kruglovvs/usbip_debugger/docs/code-specification.docx

| | УТВЕРЖДАЮ
| | _________________________
| | _________________________
| | “_____”____________20__

ВСТРОЕННОЕ ПРОГРАММНОЕ ОБЕСПЕЧЕНИЕ

Спецификация

Лист утверждения

А.В.00001-01 01

ИУ4.11.03.03.21.83.13.030 01-лу

Инв. № подл.

Подпись и дата

Взам. инв. №

Инв. № дубл.

Подпись и дата

| | Руководитель разработки
| | ______________________
| | ______________________
| | “_____”____________20__
| | Ответственный исполнитель
| | ______________________
| | ______________________
| | “_____”____________20__

УТВЕРЖДЕНО

ИУ4.11.03.03.21.83.13.030 01-лу

ВСТРОЕННОЕ ПРОГРАММНОЕ ОБЕСПЕЧЕНИЕ

Спецификация

Инв. № подл.

Подпись и дата

Взам. инв. №

Инв. № дубл.

Подпись и дата

ИУ4.11.03.03.21.83.13.030 01

Обозначение | Наименование | Примечание
| Документация
ИУ4.11.03.03.21.83.13.030 01-ЛУ | Встроенное программное
| обеспечение
| Спецификация
| Лист утверждения
ИУ4.11.03.03.21.83.13.030 12 | Встроенное программное
| обеспечение
| Текст программы
ИУ4.11.03.03.21.83.13.030 51 | Встроенное программное
| обеспечение
| Программа и методика испытаний
ИУ4.11.03.03.21.83.13.030 51-ЛУ | Встроенное программное
| обеспечение
| Программа и методика испытаний
| Лист утверждения

#### Лист регистрации изменений

Номера листов (страниц) | | | | | Всего листов (страниц) в докум | № документа | Входящий № сопрово дительного документа и дата | Подп. | Дата
Изм | изменен ных | заме ненных | новых | анулиро ванных
