kruglovvs/usbip_debugger/docs/device_speccification.pdf

Копировал | Формат A4 Инв. № подл. Подп. и дата Взам. инв. № Инв. № дубл. Подп. и дата Справ. № Перв. примен.
Изм. Лист | | № докум. | Подп. | Дата
| | Разраб. | Круглов В. С. | | JTAG/SWD программатор для удалённой отладки через Wi-Fi | Лит. | Лист | Листов
Пров. | Леонидов В. В. | | | | | | | 1

Н. контр.

Утв. Форм. | Зона | Поз. | Обозначение | Наименование | Кол. | Примечание
| | Документация
А2 | ИУ4.11.03.03.21.83.13.003 СБ | Сборочный чертёж
А4 | ИУ4.11.03.03.21.83.13.001 | Электронная ячейка
А2 | ИУ4.11.03.03.21.83.13.004 | Основание корпуса
А2 | ИУ4.11.03.03.21.83.13.005 | Крышка корпуса
| | Сборочные единицы
1 | ИУ4.11.03.03.21.83.13.001 | Электронная ячейка | 1
| | Детали
2 | ИУ4.11.03.03.21.83.13.004 | Основание корпуса | 1
3 | ИУ4.11.03.03.21.83.13.005 | Крышка корпуса | 1
| Стандартные изделия
4 | Саморез с потайной головкой M2x6-4,8-H | 4
| ГОСТ Р ИСО 7046-1-2013

МГТУ им. Н. Э. Баумана
Кафедра ИУ4
Группа ИУ4-83Б

ИУ4.11.03.03.21.83.13.003
