kruglovvs/usbip_debugger/docs/pcb_specification.pdf

Копировал | Формат A4 Инв. № подл. Подп. и дата Взам. инв. № Инв. № дубл. Подп. и дата Справ. № Перв. примен.
Изм. Лист | | № докум. | Подп. | Дата
| | Разраб. | Круглов В. С. | | Плата печатная многослойная | Лит. | Лист | Листов
Пров. | Леонидов В. В. | | | | | | | 1

Н. контр.

Утв. Форм. | Зона | Поз. | Обозначение | Наименование | Кол. | Примечание
| | Документация
А2 | ИУ4.11.03.03.21.83.13.002 СБ | Сборочный чертёж
| ИУ4.11.03.03.21.83.13.002 М | Плата печатная данные элементов структуры
А4 | ИУ4.11.03.03.21.83.13.002 М-ЛУ | Плата печатная данные элементов структуры
| | лист утверждения
| Материалы
1 | Стеклотекстолит FR4 ТУ И03.0107.008-94 | 1313 | мм²
2 | Препрег ТУ 5952-007-20552865-2015 | 2625 | мм²
3 | Фольга медная толщина 18мкм | 5250 | мм²
| ТУ 1844-004-99267323-2008

МГТУ им. Н. Э. Баумана
Кафедра ИУ4
Группа ИУ4-83Б

ИУ4.11.03.03.21.83.13.002
