kruglovvs/usbip_debugger/docs/pcba_specification.pdf

Копировал | Формат A4 Инв. № подл. Подп. и дата Взам. инв. № Инв. № дубл. Подп. и дата Справ. № Перв. примен.
Изм. Лист | | № докум. | Подп. | Дата
| | Разраб. | Круглов В. С. | | Электронная ячейка JTAG/SWD программатора для удалённой отладки через Wi-Fi | Лит. | Лист | Листов
Пров. | Леонидов В. В. | | | | | | 1 | 2

Н. контр.

Утв. Форм. | Зона | Поз. | Обозначение | Наименование | Кол. | Примечание
| | Документация
А2 | ИУ4.11.03.03.21.83.13.001 СБ | Сборочный чертёж
А2 | ИУ4.11.03.03.21.83.13.001 Э1 | Схема электрическая структурная
А3 | ИУ4.11.03.03.21.83.13.001 Э2 | Схема электрическая функциональная
А2 | ИУ4.11.03.03.21.83.13.001 Э3 | Схема электрическая принципиальная
А2 | ИУ4.11.03.03.21.83.13.001 Э4 | Схема электрическая соединений
| ИУ4.11.03.03.21.83.13.001 М | Встроенное программное обеспечение
А4 | ИУ4.11.03.03.21.83.13.001 М-ЛУ | Встроенное программное обеспечение
| | лист утверждения
А4 | ИУ4.11.03.03.21.83.13.001 ПЭ3 | Перечень элементов
А2 | ИУ4.11.03.03.21.83.13.002 | Плата печатная многослойная
| | Сборочные единицы
1 | ИУ4.11.03.03.21.83.13.002 | Плата печатная многослойная | 1
| Прочие изделия
| Разъёмы
2 | USB4110-GF-A (GCT, США) | 1 | XS1
3 | 2213SM-10G-TB (Multicomp, Австралия) | 1 | XP1
| Конденсаторы
4 | GRM188R61C106KAALD (Murata, Япония) | 6 | C1..C6
5 | GRM1885C1H6R3WA01D (Murata, Япония) 1 | | C7
| Резисторы
6 | Р1-12-0,125-43Ом±5%-М-"А" | 3 | R4, R6, R9
7 | Р1-12-0,125-68Ом±5%-М-"А" | 5 | R14..R18
8 | Р1-12-0,125-5,1кОм±5%-М-"А" | 4 | R1..R3, R8
9 | Р1-12-0,125-24кОм±5%-М-"А" | 2 | R5, R7
| | ИУ4.11.03.03.21.83.13.001

МГТУ им. Н. Э. Баумана
Кафедра ИУ4
Группа ИУ4-83Б

Копировал | Формат A4 Инв. № подл. Подп. и дата Взам. инв. № Инв. № дубл. Подп. и дата Справ. № Перв. примен.
Изм. Лист | № докум. | Подп. | Дата

Лист

2 Форм. | Зона | Поз. | Обозначение | Наименование | Кол. | Примечание
| | 10 | | Р1-12-0,125-100кОм±10%-М-"А" | 4 | R10..R13
| Светодиоды
11 | FYLS-0603UGC (Foryard, Китай) | 1 | VD1
12 | FYLS-0603UBC (Foryard, Китай) | 1 | VD2
13 | FYLS-0603URC (Foryard, Китай) | 1 | VD3
| Микросхемы
14 | SRV05-4.TCT (Semtech, США) | 1 | DA1
15 | TLV62569DBVR (Texas Instruments, США) | 1 | DA2
16 | TXB0106PWR (Texas Instruments, США) | 1 | DD2
17 | ESP32-S3-WROOM-1-N16R8 (Espressif, Китай) 1 | | DD1
18 | IHLP2020CZER2R2M01 (Vishay Intertechnology, США) | 1 | L1

ИУ4.11.03.03.21.83.13.001
