kruglovvs/usbip_debugger/docs/bomdoc.pdf

Копировал | Формат A4 Инв. № подл. Подп. и дата Взам. инв. № Инв. № дубл. Подп. и дата Справ. № Перв. примен.
Изм. Лист | № докум. | Подп. | Дата
| Разраб. | Круглов В. С. | | Электронная ячейка JTAG/SWD программатора для удалённой отладки через Wi-Fi Перечень элементов | Лит. | Лист | Листов
Пров. | | | | | | | 1

Н. контр.
Утв.
Поз. обозначение | Наименование | Кол. | Примечание
| Разъёмы
XS1 | USB4110-GF-A (GCT, США) | 1
XP1 | 2213SM-10G-TB (Multicomp, Австралия) | 1
| Конденсаторы
C1..C6 | GRM188R61C106KAALD (Murata, Япония) | 6
C7 | GRM1885C1H6R3WA01D (Murata, Япония) | 1
| Резисторы
R4, R6, R9 Р1-12-0,125-43Ом±5%-М-"А" | | 3
R14..R18 | Р1-12-0,125-68Ом±5%-М-"А" | 5
R1..R3, R8 | Р1-12-0,125-5,1кОм±5%-М-"А" | 4
R5, R7 | Р1-12-0,125-24кОм±5%-М-"А" | 2
R10..R13 | Р1-12-0,125-100кОм±10%-М-"А" | 4
| Светодиоды
VD1 | FYLS-0603UGC (Foryard, Китай) | 1
VD2 | FYLS-0603UBC (Foryard, Китай) | 1
VD3 | FYLS-0603URC (Foryard, Китай) | 1
| Микросхемы
DA1 | SRV05-4.TCT (Semtech, США) | 1
DA2 | TLV62569DBVR (Texas Instruments, США) | 1
DD2 | TXB0106PWR (Texas Instruments, США) | 1
DD1 | ESP32-S3-WROOM-1-N16R8 (Espressif, Китай) | 1
L1 | IHLP2020CZER2R2M01 (Vishay, США) | 1

# ИУ4.11.03.03.21.83.13.001 ПЭ3

МГТУ им. Н. Э. Баумана
Кафедра ИУ4
Группа ИУ4-83Б

# Леонидов В. В. ИУ4.11.03.03.2¹.83.13.00¹
