kruglovvs/usbip_debugger/docs/gerber_lu.pdf

Копировал | Формат A4 Инв. № подл. Подп. и дата Взам. инв. № Инв. № дубл. Подп. и дата Справ. № Перв. примен.
Изм. Лист | | № докум. | Подп. | Дата
| | Разраб. | Круглов В. С. | | Плата печатная многослойная данные элементов структуры Информационно-удостоверяющий лист | Лит. | Лист | Листов
Пров. | Леонидов В. В. | | | | | | | 1

Н. контр.
Утв.
| | Номер п/п | Обозначение | Наименование документа | Версия | Дата последнего изменения
| | 1 ИУ4.11.03.03.21.83.13.002 М | | Плата печатная многослойная данные элементов структуры
MD5 | b7d25142cd10724d77d720eb7b6e8429
Имя файла | Примечание

gerbers.zip

# ИУ4.11.03.03.21.83.13.002 М-УЛ

МГТУ им. Н. Э. Баумана
Кафедра ИУ4
Группа ИУ4-83Б
