kruglovvs/usbip_debugger/docs/thermal.pdf

## Моделирование теплового режима

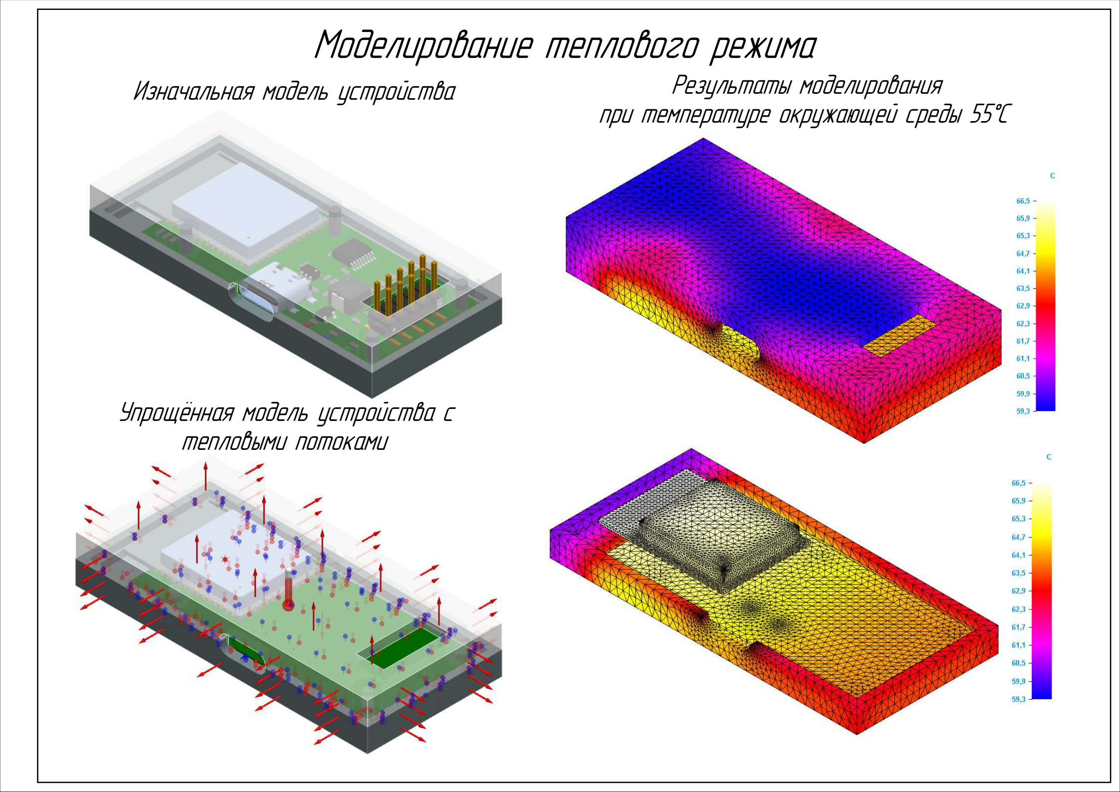
[picture p82: page 1]

Изначальная модель устройства | Результаты моделирования при температуре окружающей среды 55°C

Упрощённая модель устройства с тепловыми потоками
