kruglovvs/usbip_debugger/hardware/case/pattern.stp

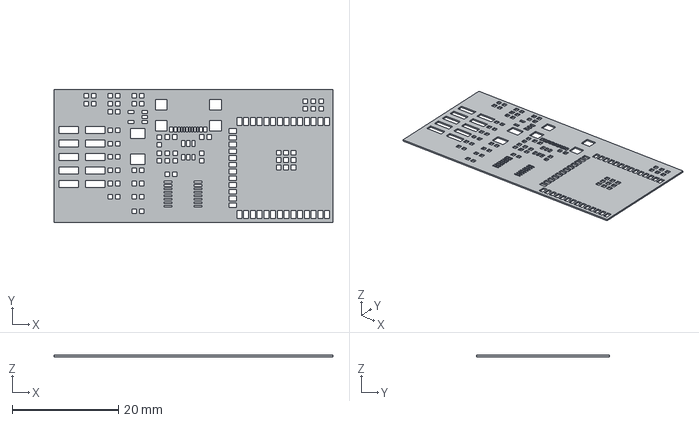
[picture p83: CAD file, 2025-06-28]
hardware/case/pattern.stp
52.5 x 25.0 x 0.3 mm
