kruglovvs/usbip_debugger/hardware/case/pcb-3d/pcb.step

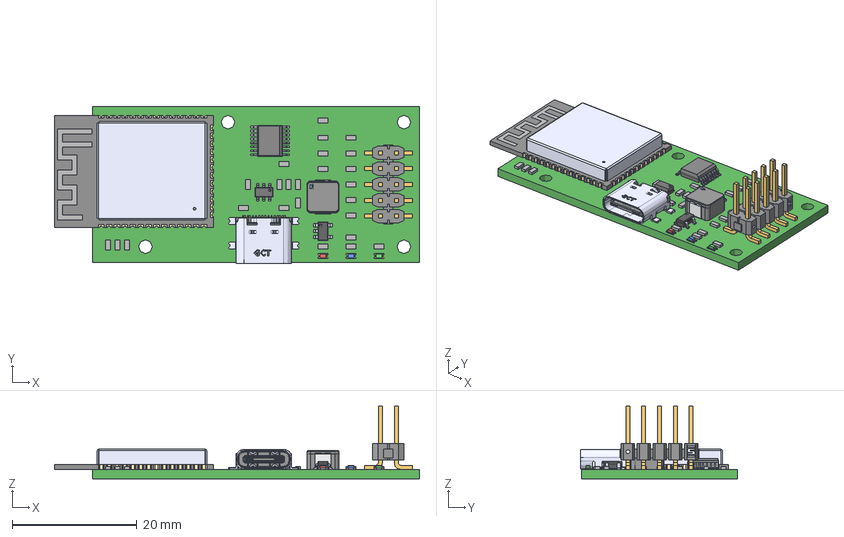
[picture p84: CAD file, 2025-06-28]
hardware/case/pcb-3d/pcb.step
58.6 x 25.2 x 11.7 mm
SW3dPS-0603_SMD_Capacitor x 7
Extruded x 25
chip_0603_r x 18
SOT23-5-1
ssop16
GCT
IHLP2020AB
Vishay_logo_-_Copy
Vishay_logo
T-1S6-16(-01-5-DV)
TSM-105-01-DV_body
logo
User_Library-LED_0603_R_Pocket002
User_Library-LED_0603_R_Pad004
User_Library-LED_0603_R_Fillet
User_Library-LED_0603_R_Pocket001
User_Library-LED_0603_R_Pad
User_Library-LED_0603_B_Pocket002
User_Library-LED_0603_B_Pad004
User_Library-LED_0603_B_Fillet
User_Library-LED_0603_B_Pocket001
User_Library-LED_0603_B_Pad
User_Library-LED_0603_G_Pocket002
User_Library-LED_0603_G_Pad004
User_Library-LED_0603_G_Fillet
User_Library-LED_0603_G_Pocket001
User_Library-LED_0603_G_Pad
User_Library-SOT23-6-2
