kruglovvs/usbip_debugger/hardware/model/FEM/heat.FCStd

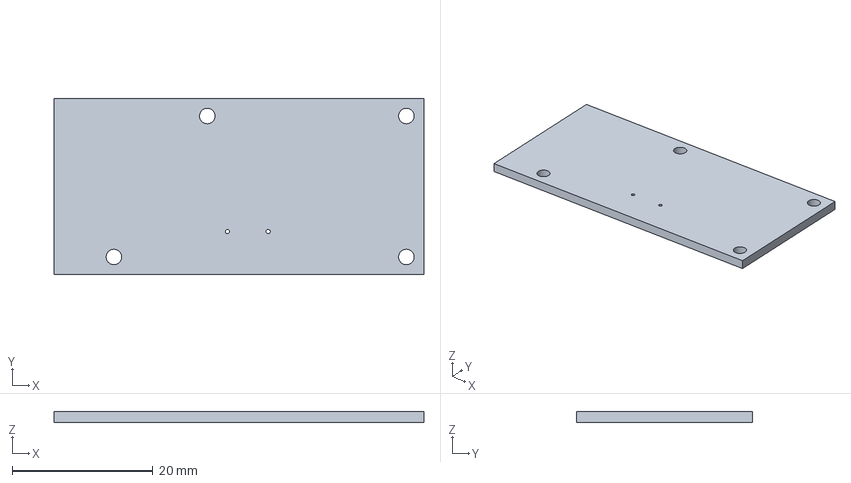
[picture p85: CAD file, 2025-06-28]
hardware/model/FEM/heat.FCStd
52.5 x 25.0 x 1.52 mm
