kruglovvs/usbip_debugger/docs/3D_assembly.pdf

## Последовательность сборки

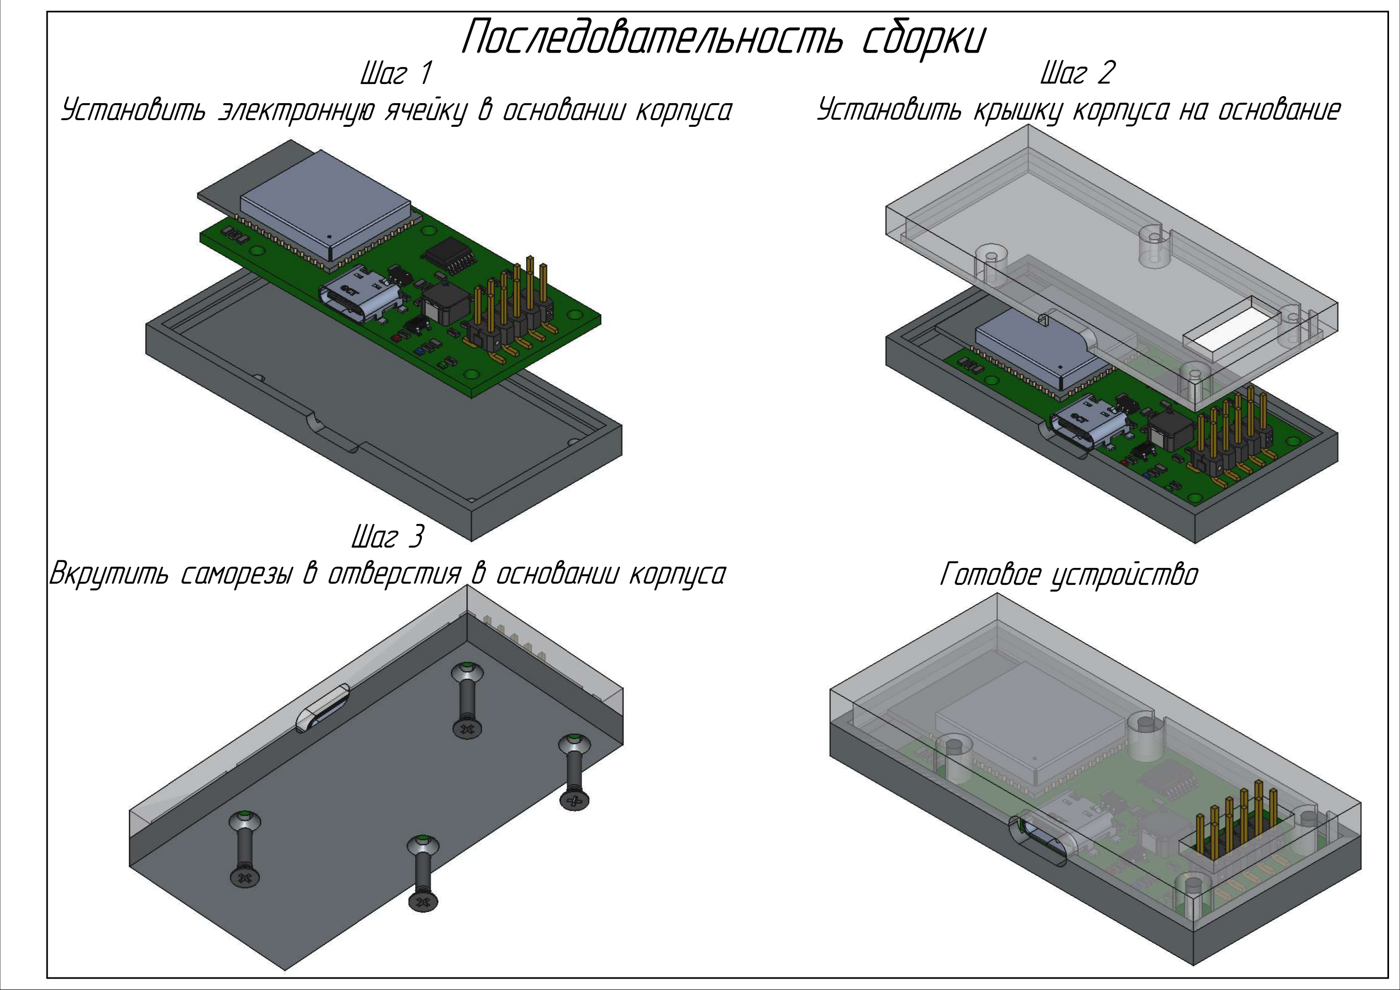
[picture p86: page 1]

Шаг 1
Установить электронную ячейку в основании корпуса

Шаг 2
Установить крышку корпуса на основание

Шаг 3
Вкрутить саморезы в отверстия в основании корпуса | Готовое устройство
