kruglovvs/usbip_debugger/docs/assembly.pdf

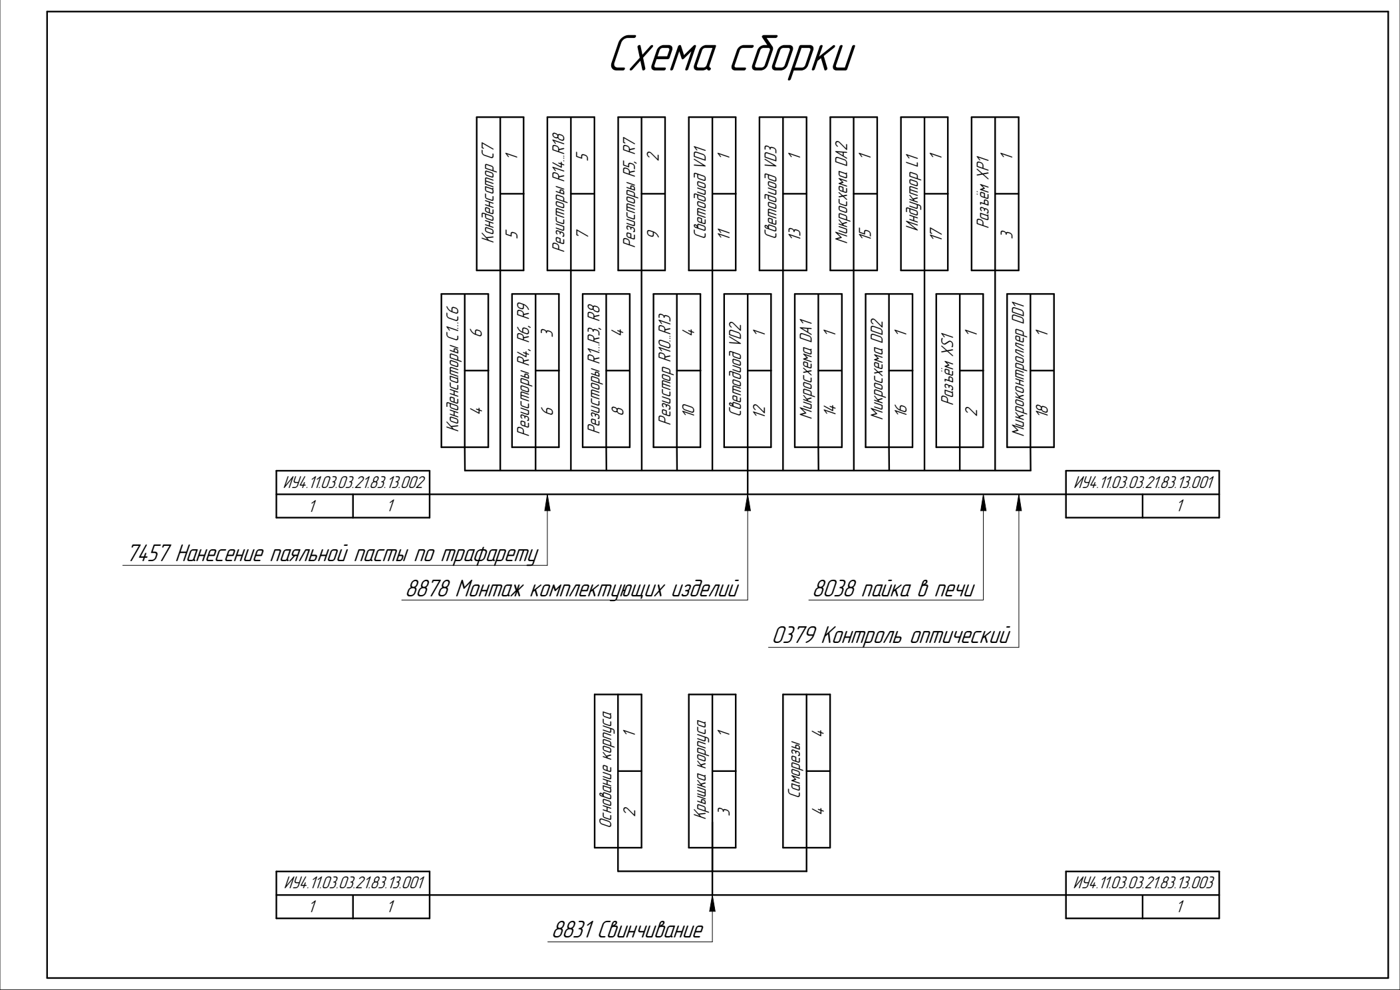
[picture p87: figure]
0379 Контроль оптический; 8831 Свинчивание; 1 Основание корпуса; 1 Крышка корпуса 3 1 Саморезы; Конденсаторы C¹...C6; 6 Резисторы R4, R6, R9 6 3 Резисторы R1...R3, R8 8; 1 Резисторы R14...R18 7; 5 Светодиод VD2 12; 1 Микросхема DA1 14; 1 Микросхема DD2 16 1 Разъём XS1; 1 Резисторы R5, R7 9 2 Светодиод VD1 11; 1 Светодиод VD3 13; 1 Микросхема DA2 15 1 Индуктор L1 17; 1 Разъём XP1; 1 Микроконтроллер DD1 18; Схема сборки

# 8878 Монтаж комплектующих изделий 8038 пайка в печи

# 7457 Нанесение паяльной пасты по трафарету

ИУ4.11.03.03.21.83.13.002 | ИУ4.11.03.03.21.83.13.001

### 4 Резистор R10...R13 10 4 Конденсатор C7 5
