kruglovvs/usbip_debugger/docs/testing.pdf

## Испытание устройства

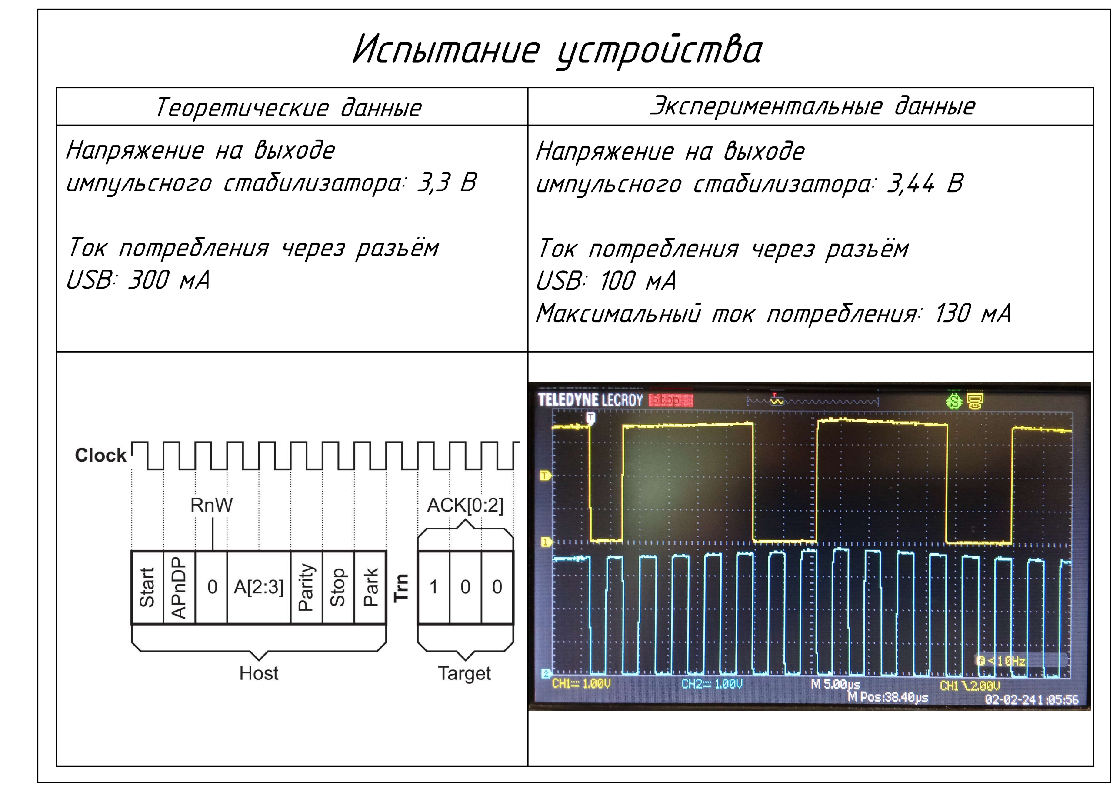
[picture p88: page 1]

Теоретические данные | Экспериментальные данные
Напряжение на выходе импульсного стабилизатора: 3,3 В Ток потребления через разъём USB: 300 мА | Напряжение на выходе импульсного стабилизатора: 3,44 В Ток потребления через разъём USB: 100 мА Максимальный ток потребления: 130 мА
