kruglovvs/usbip_debugger/docs/schematic.pdf

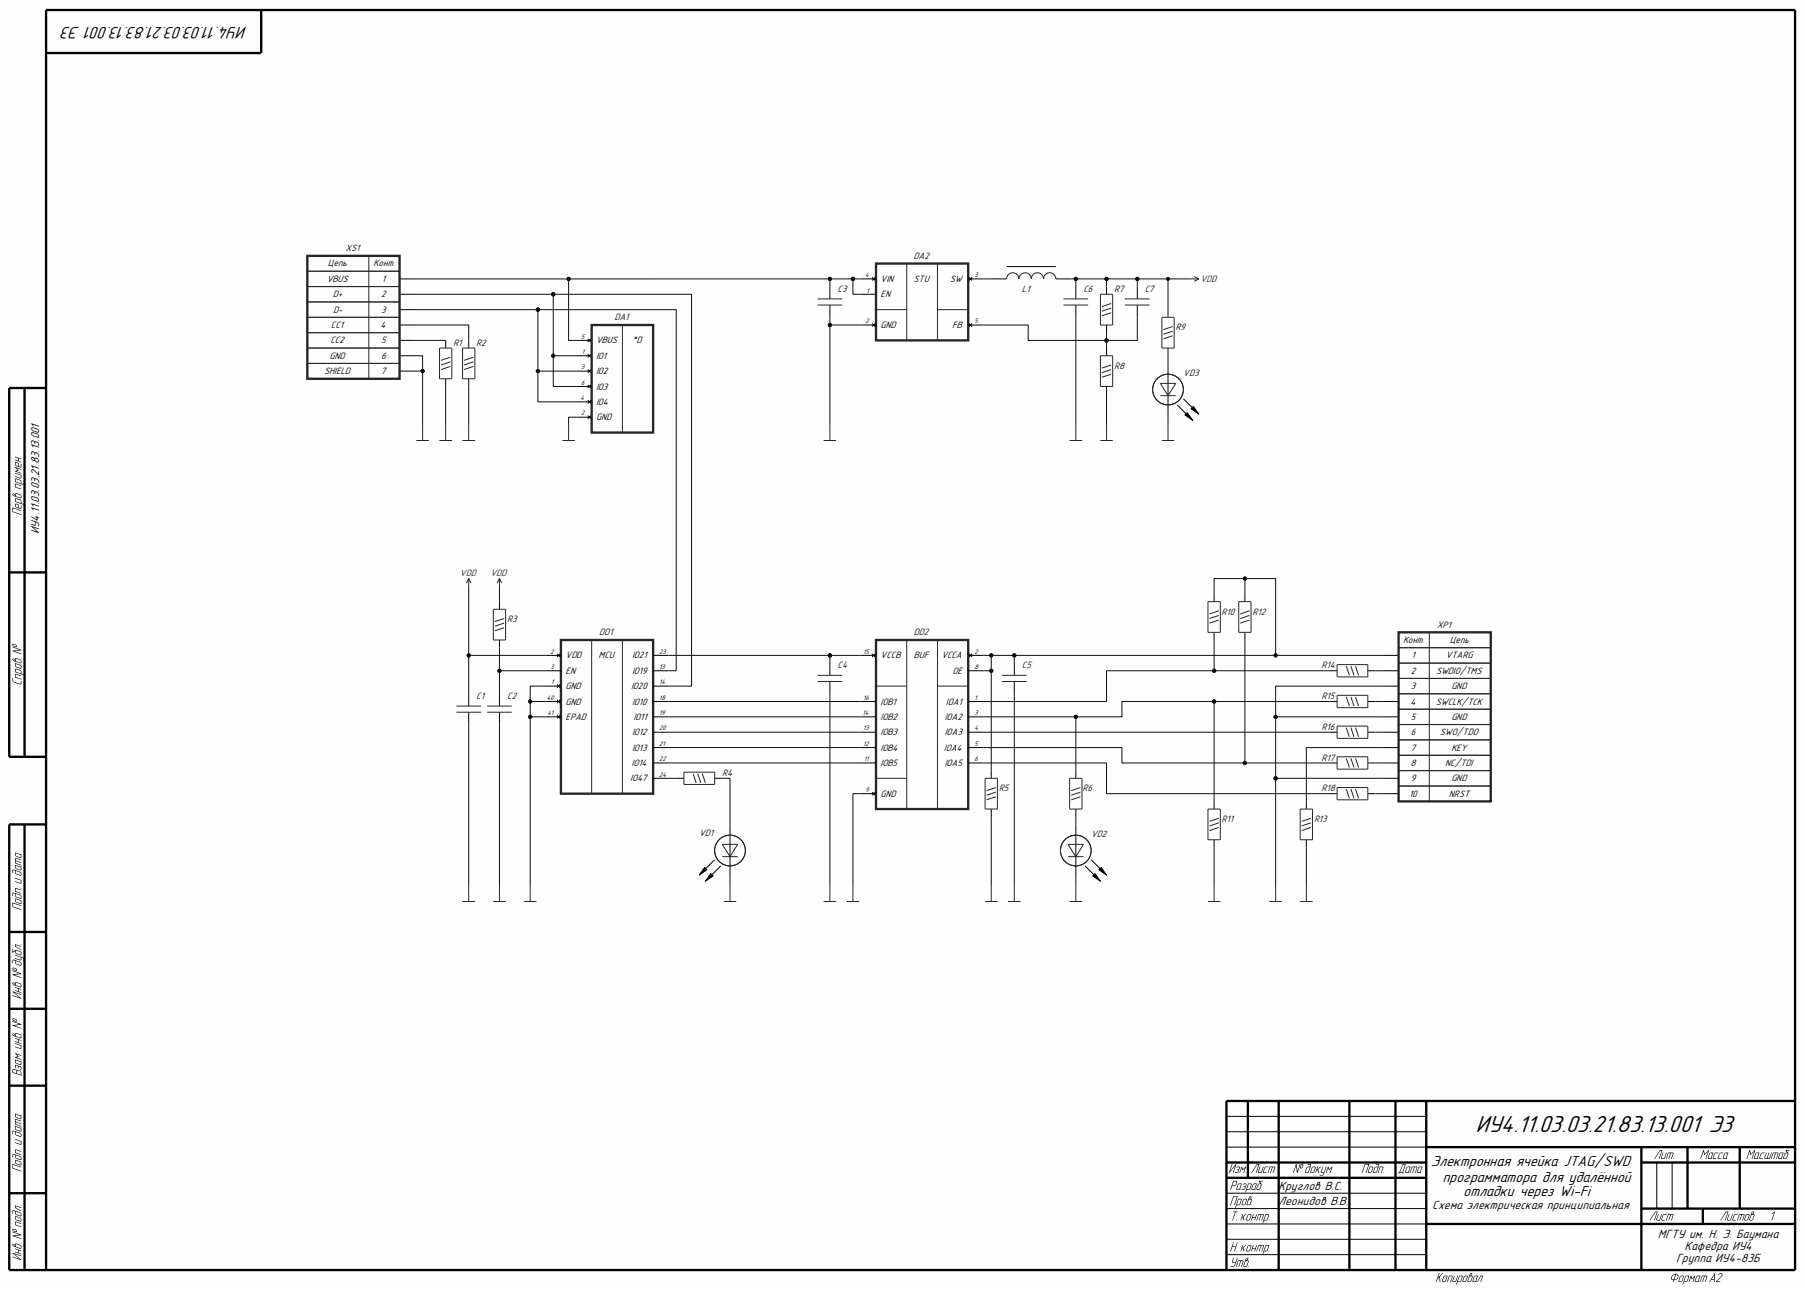
[picture p89: page 1]

Цепь | Конт.
VBUS | 1
D+ | 2
D- | 3
CC1 | 4
CC2 | 5
GND | 6
SHIELD | 7

Конт. | Цепь
1 | VTARG
2 | SWDIO/TMS
3 | GND
4 | SWCLK/TCK
5 | GND
6 | SWO/TDO
7 | KEY
8 NC/TDI

9 | GND
10 | NRST

Электронная ячейка JTAG/SWD программатора для удалённой отладки через Wi-Fi Схема электрическая принципиальная

Круглов В.С.
Леонидов В.В.

МГТУ им. Н. Э. Баумана Кафедра ИУ4 Группа ИУ4-83Б
