kruglovvs/usbip_debugger/docs/algorithm.pdf

## Алгоритм работы

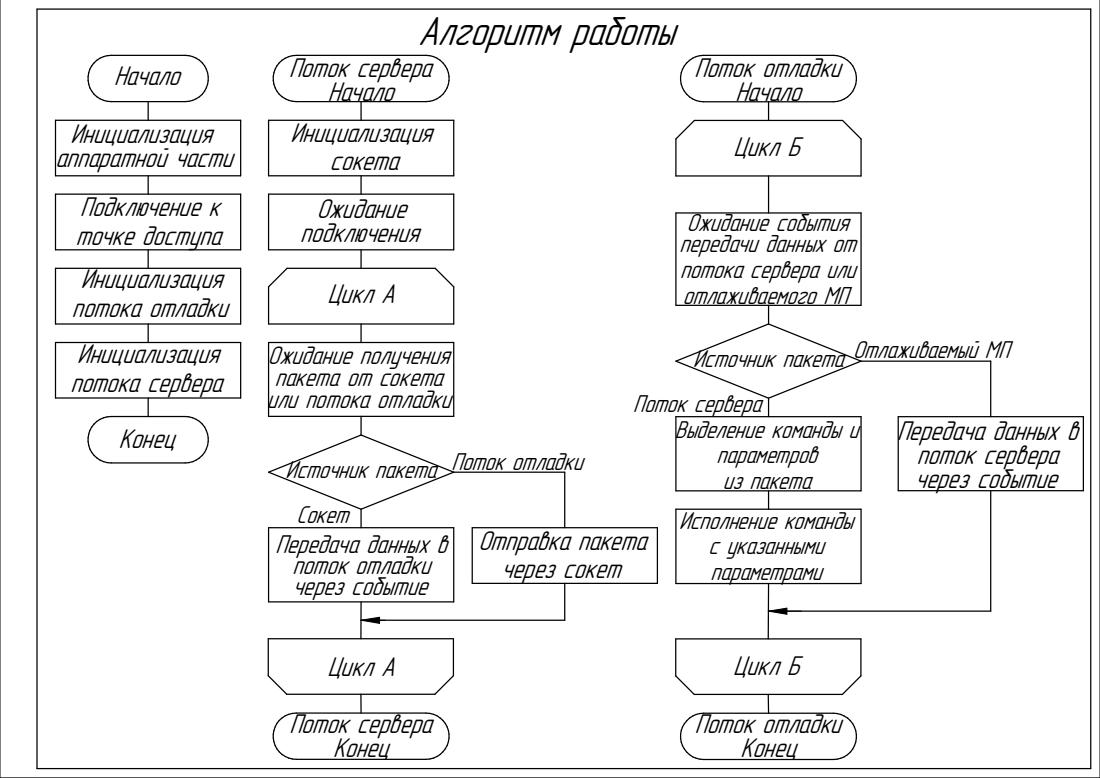
[picture p90: page 1]
Начало; Инициализация аппаратной части; Инициализация потока отладки; Инициализация потока сервера; Источник пакета; Подключение к точке доступа; Поток сервера Начало; Конец; Инициализация сокета; Ожидание подключения; Передача данных в поток отладки через событие; Отправка пакета через сокет; Поток сервера Конец; Поток отладки Начало; Выделение команды и параметров из пакета; Передача данных в поток сервера через событие; Поток отладки Конец; Исполнение команды с указанными параметрами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

Ожидание события
передачи данных от
потока сервера или
отлаживаемого МП

Ожидание получения
пакета от сокета
или потока отладки
