kruglovvs/usbip_debugger/docs/bottom.pdf

20 js12 28,25 js¹2 | 4¹,5 js¹2 0,5

1,5

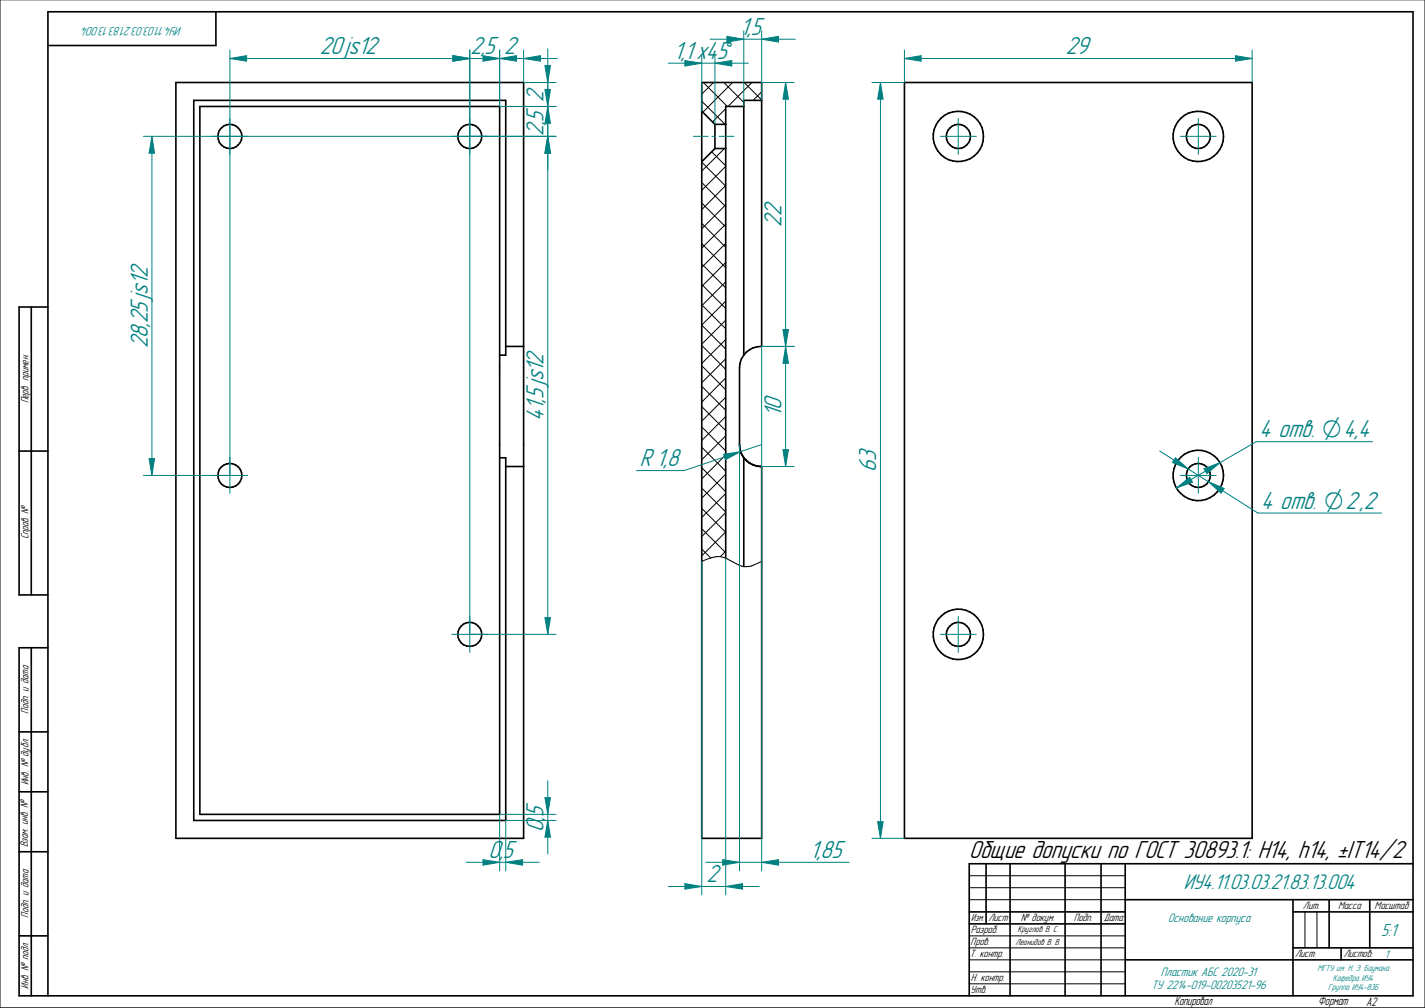
[picture p91: page 1]
Копировал; Формат A2; 4 отв.

Инв. № подл. Подп. и дата Взам. инв. № Инв. № дубл. Подп. и дата Справ. № Перв. примен.

Общие допуски по ГОСТ 30893.1: Н14, h14, ±IТ14/2

Основание корпуса | Лит. | Масса | Масштаб

Изм. Лист | № докум. | Подп. | Дата | | | | | 5:1
Разраб. | Круглов В. С.
Пров. | Леонидов В. В.
Т. контр. | | | | Лист: | Листов: 1

Пластик АБС 2020-31 ТУ 2214-019-00203521-96 | МГТУ им. Н. Э. Баумана Кафедра ИУ4 Группа ИУ4-83Б

Н. контр.
Утв.
