kruglovvs/usbip_debugger/docs/cover.pdf

0,5 0,5 2,5

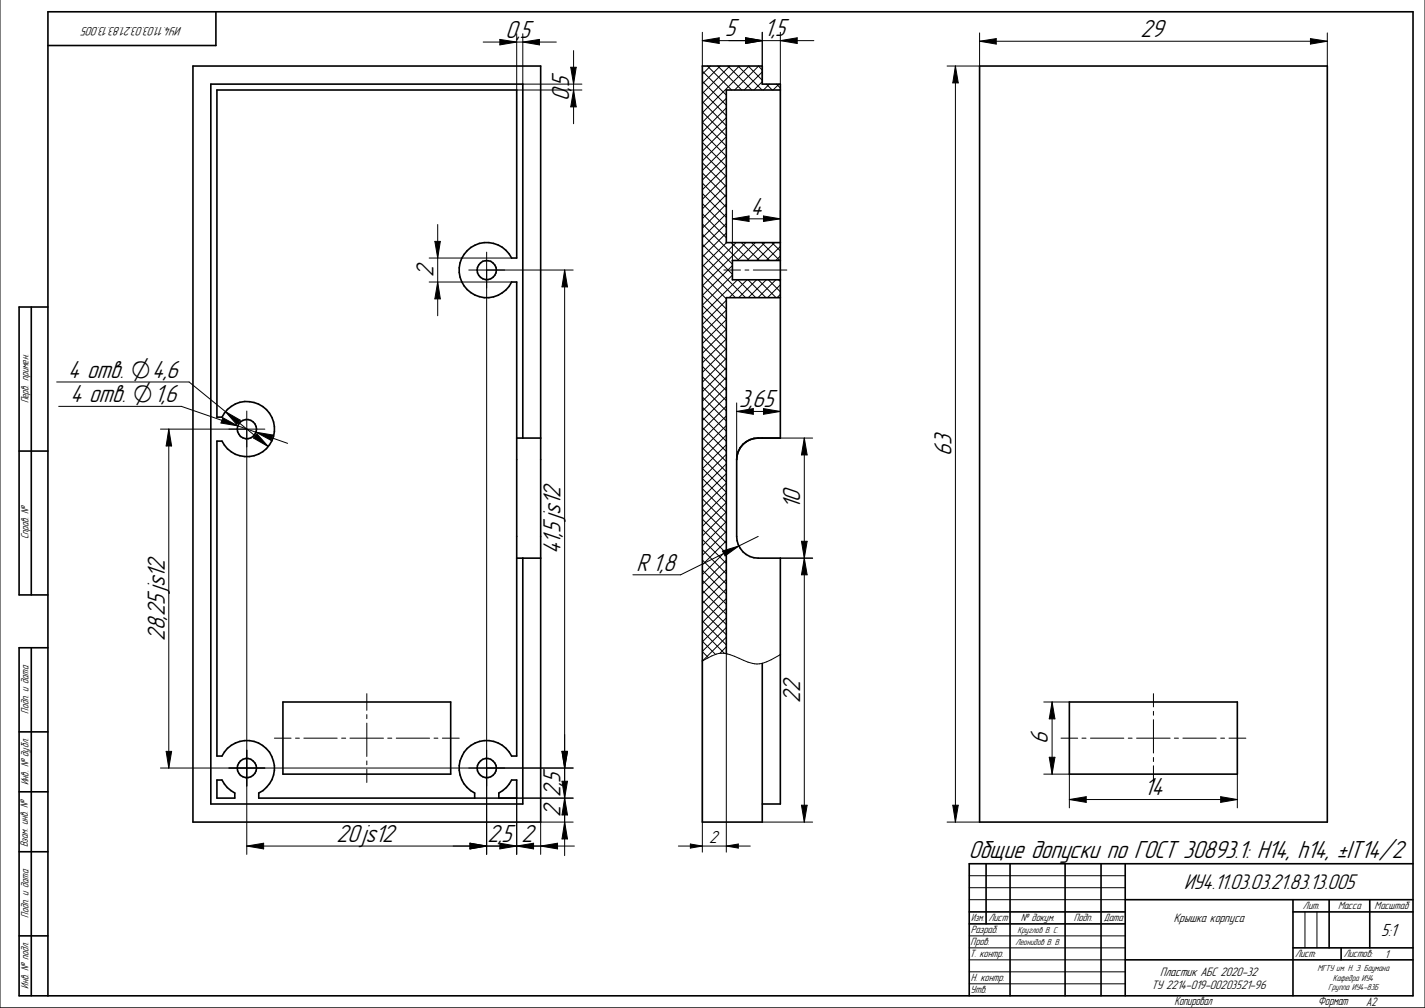
[picture p92: page 1]
Копировал; Формат A2; 20 js12 ²⁸,25 js¹2; 4¹,5 js¹2 2 ²

Инв. № подл. Подп. и дата Взам. инв. № Инв. № дубл. Подп. и дата Справ. № Перв. примен.
4 отв.

Общие допуски по ГОСТ 30893.1: Н14, h14, ±IТ14/2

Крышка корпуса | Лит. | Масса | Масштаб

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

Пластик АБС 2020-32 ТУ 2214-019-00203521-96 | МГТУ им. Н. Э. Баумана Кафедра ИУ4 Группа ИУ4-83Б

Н. контр.
Утв.
