kruglovvs/usbip_debugger/docs/device.pdf

14*

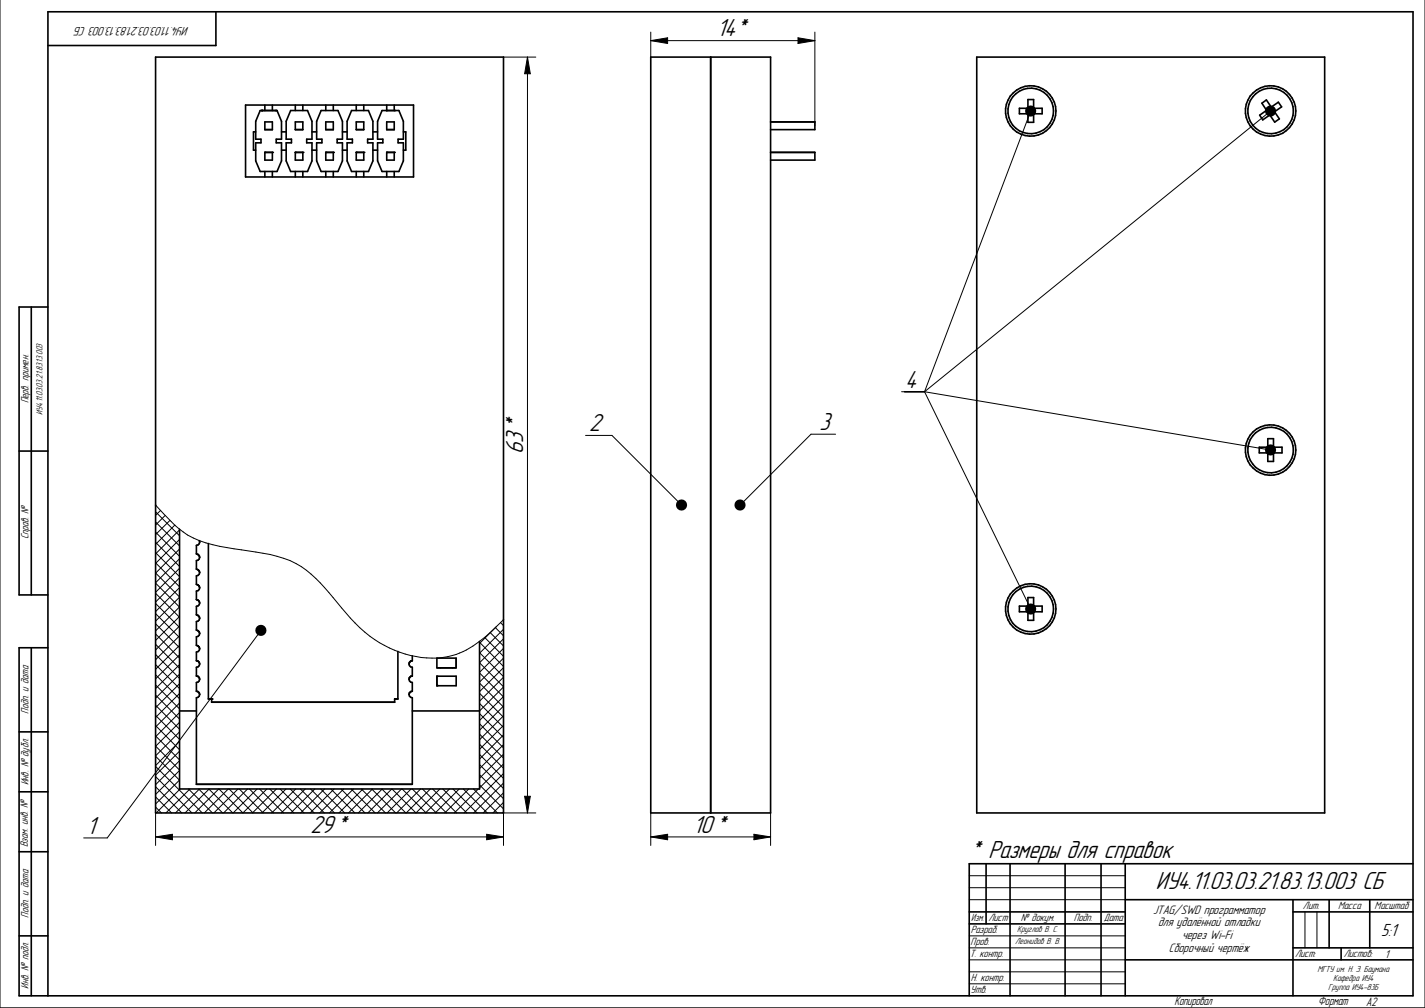
[picture p93: page 1]
Копировал; Формат A2

Инв. № подл. Подп. и дата Взам. инв. № Инв. № дубл. Подп. и дата Справ. № Перв. примен.

* Размеры для справок

JTAG/SWD программатор для удалённой отладки через Wi-Fi Сборочный чертёж | Лит. | Масса | Масштаб

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

МГТУ им. Н. Э. Баумана Кафедра ИУ4 Группа ИУ4-83Б

Н. контр.
Утв.
