kruglovvs/usbip_debugger/docs/functions.pdf

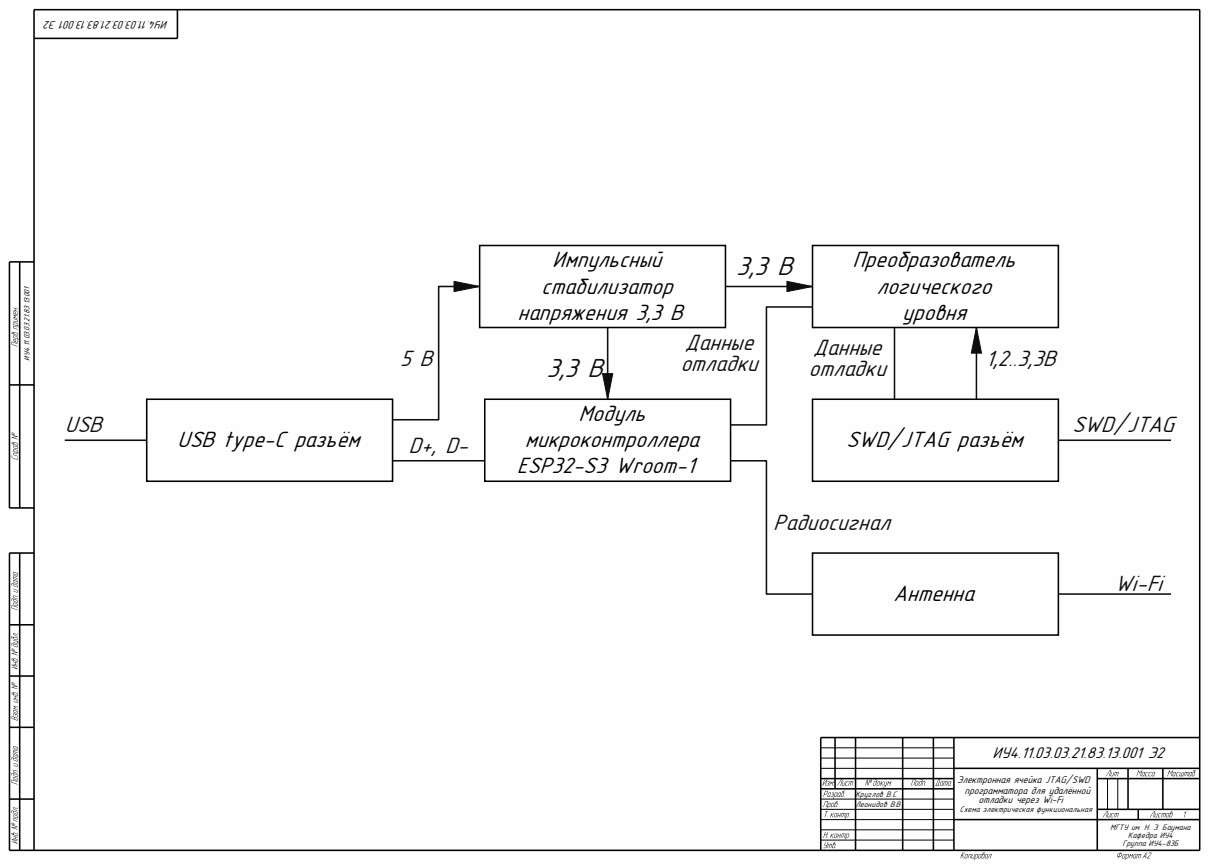
[picture p94: page 1]
USB; SWD/JTAG; Модуль микроконтроллера ESP32-S3 Wroom-1; Антенна; Импульсный стабилизатор напряжения 3,3 В; Преобразователь логического уровня; Данные отладки; Радиосигнал

USB type-С разъём

SWD/JTAG разъём

Электронная ячейка JTAG/SWD программатора для удалённой отладки через Wi-Fi Схема электрическая функциональная

Круглов В.С.
Леонидов В.В.

МГТУ им. Н. Э. Баумана Кафедра ИУ4 Группа ИУ4-83Б
