kruglovvs/usbip_debugger/docs/pattern.pdf

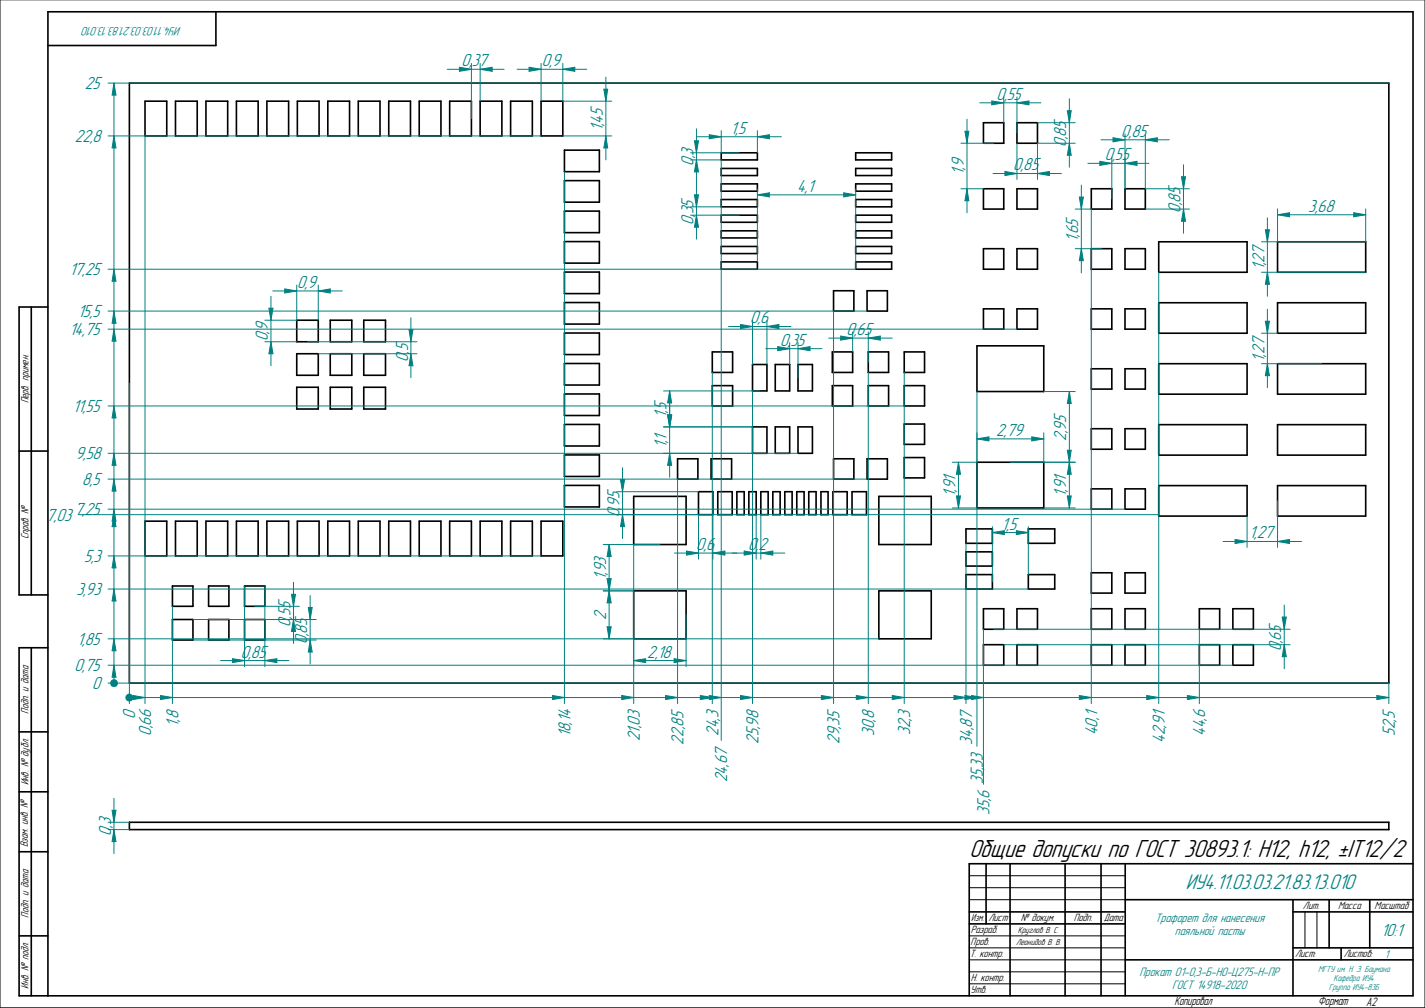
[picture p95: page 1]
Копировал; Формат A2

Инв. № подл. Подп. и дата Взам. инв. № Инв. № дубл. Подп. и дата Справ. № Перв. примен.

Общие допуски по ГОСТ 30893.1: Н12, h12, ±IТ12/2

Трафарет для нанесения паяльной пасты | Лит. | Масса | Масштаб

Изм. Лист | № докум. | Подп. | Дата | | | | | 10:1
Разраб. | Круглов В. С.
Пров. | Леонидов В. В.
Т. контр. | | | | Лист: | Листов: 1

Прокат 01-0,3-Б-НО-Ц275-Н-ПР ГОСТ 14918-2020 | МГТУ им. Н. Э. Баумана Кафедра ИУ4 Группа ИУ4-83Б

Н. контр.
Утв.
