kruglovvs/usbip_debugger/docs/pcb.pdf

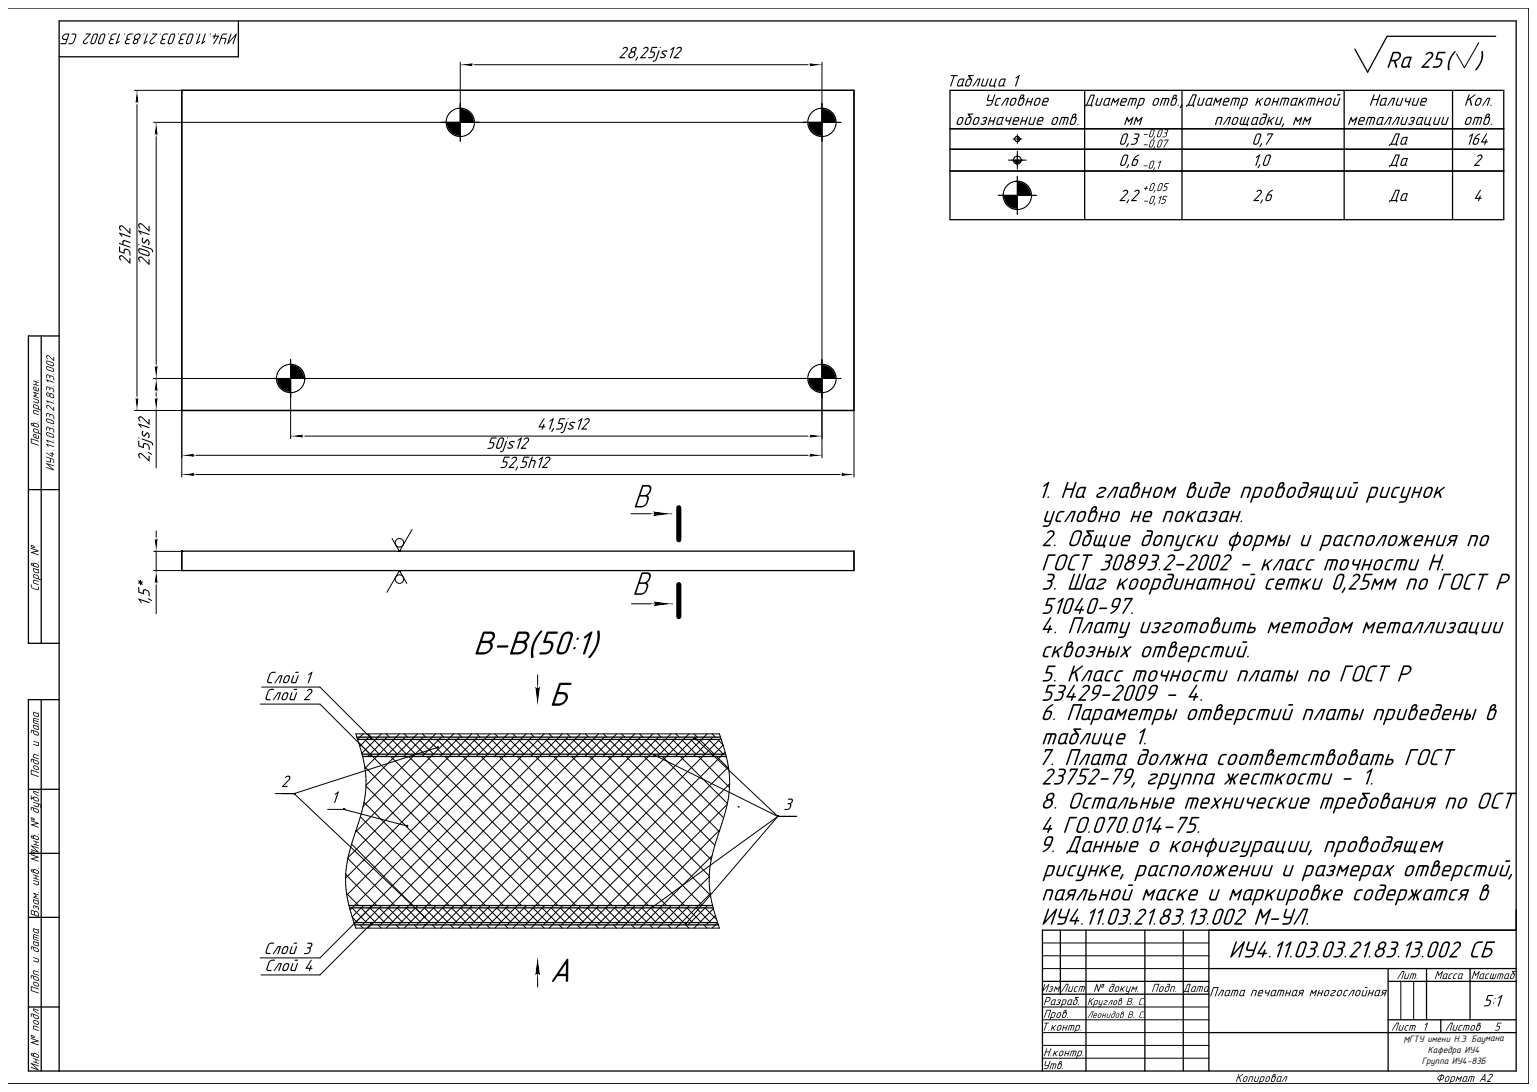
[picture p96: page 1]
Кафедра ИУ4 Группа ИУ4-83Б

МГТУ имени Н.Э. Баумана

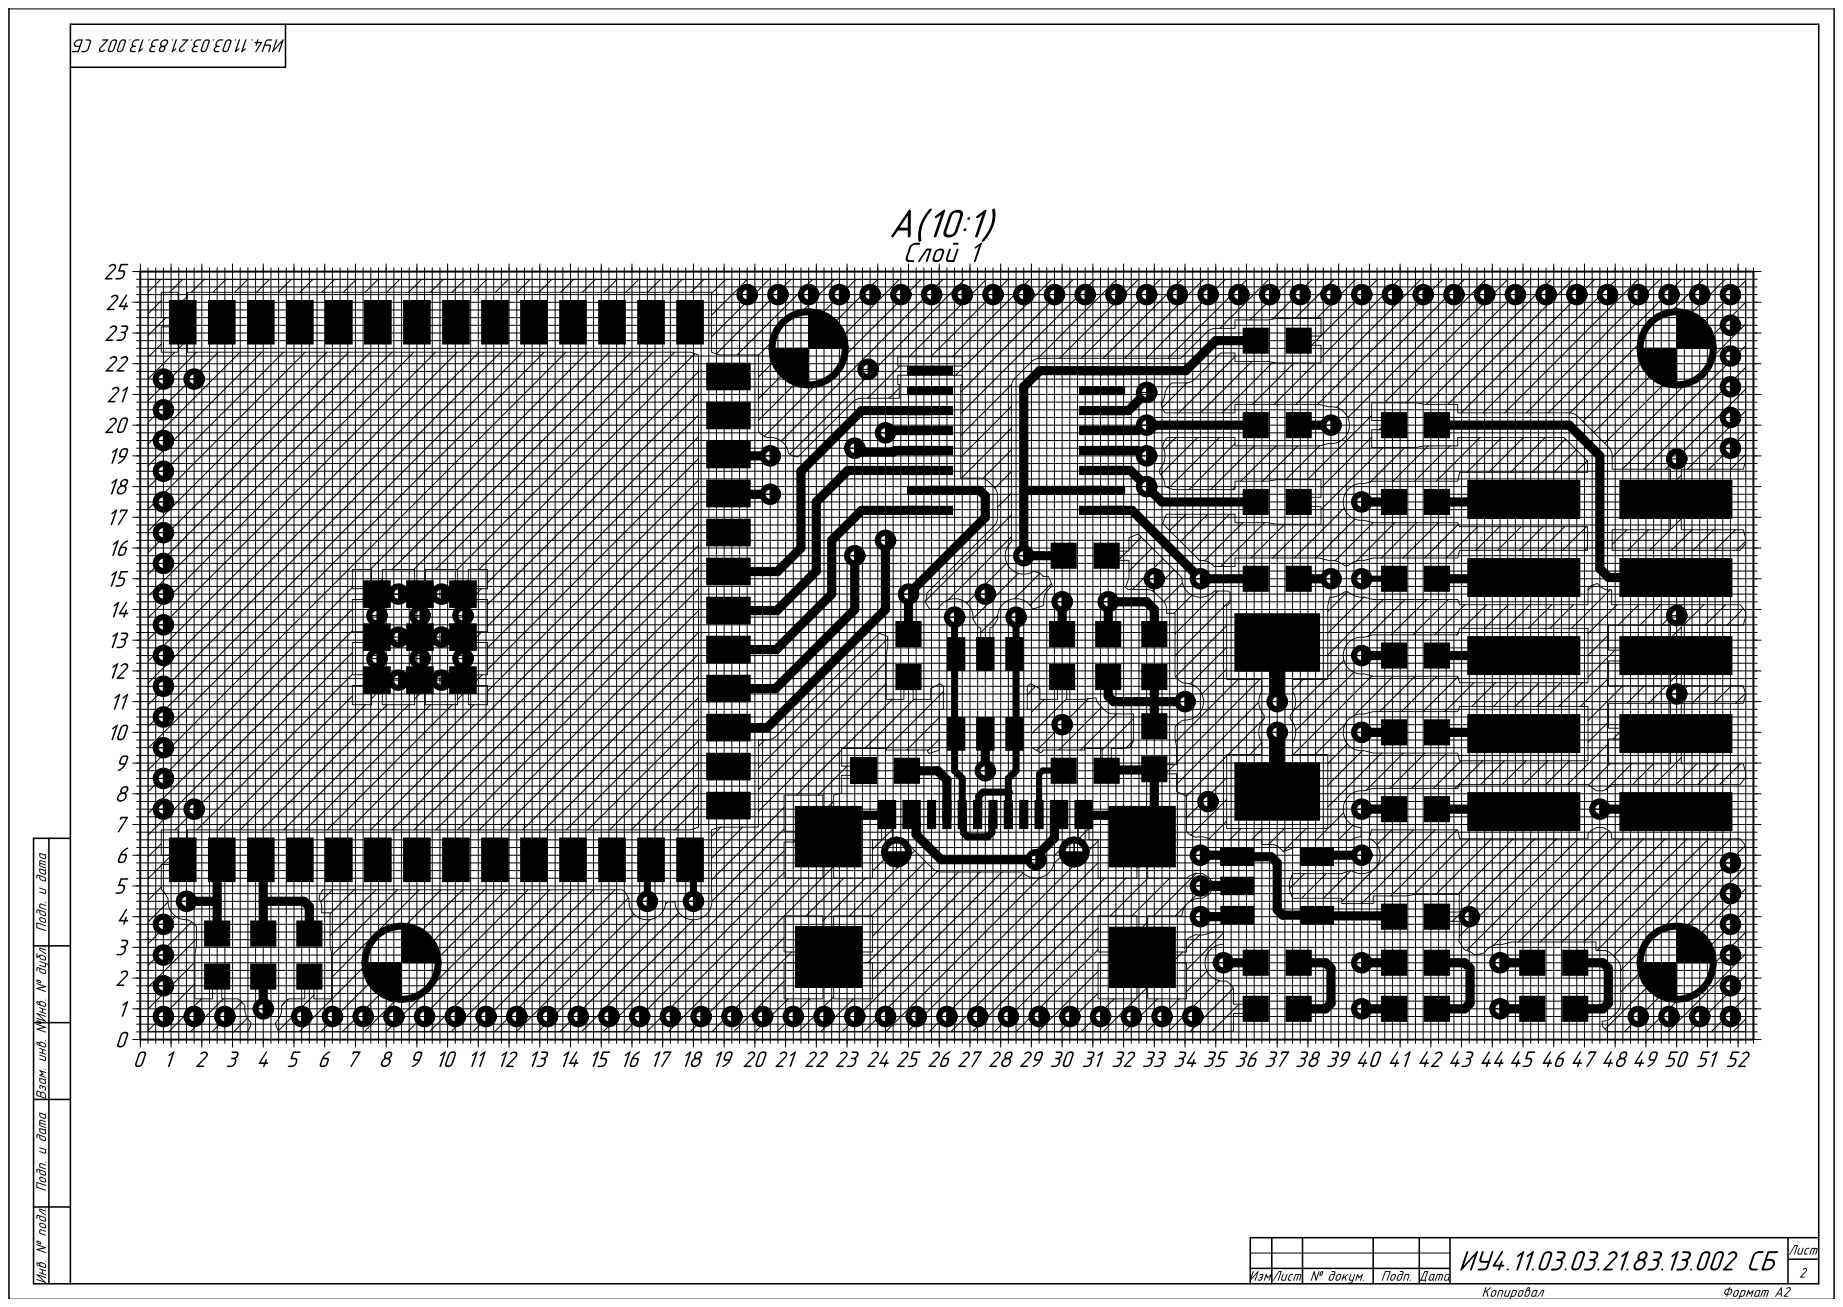
[picture p97: page 2]

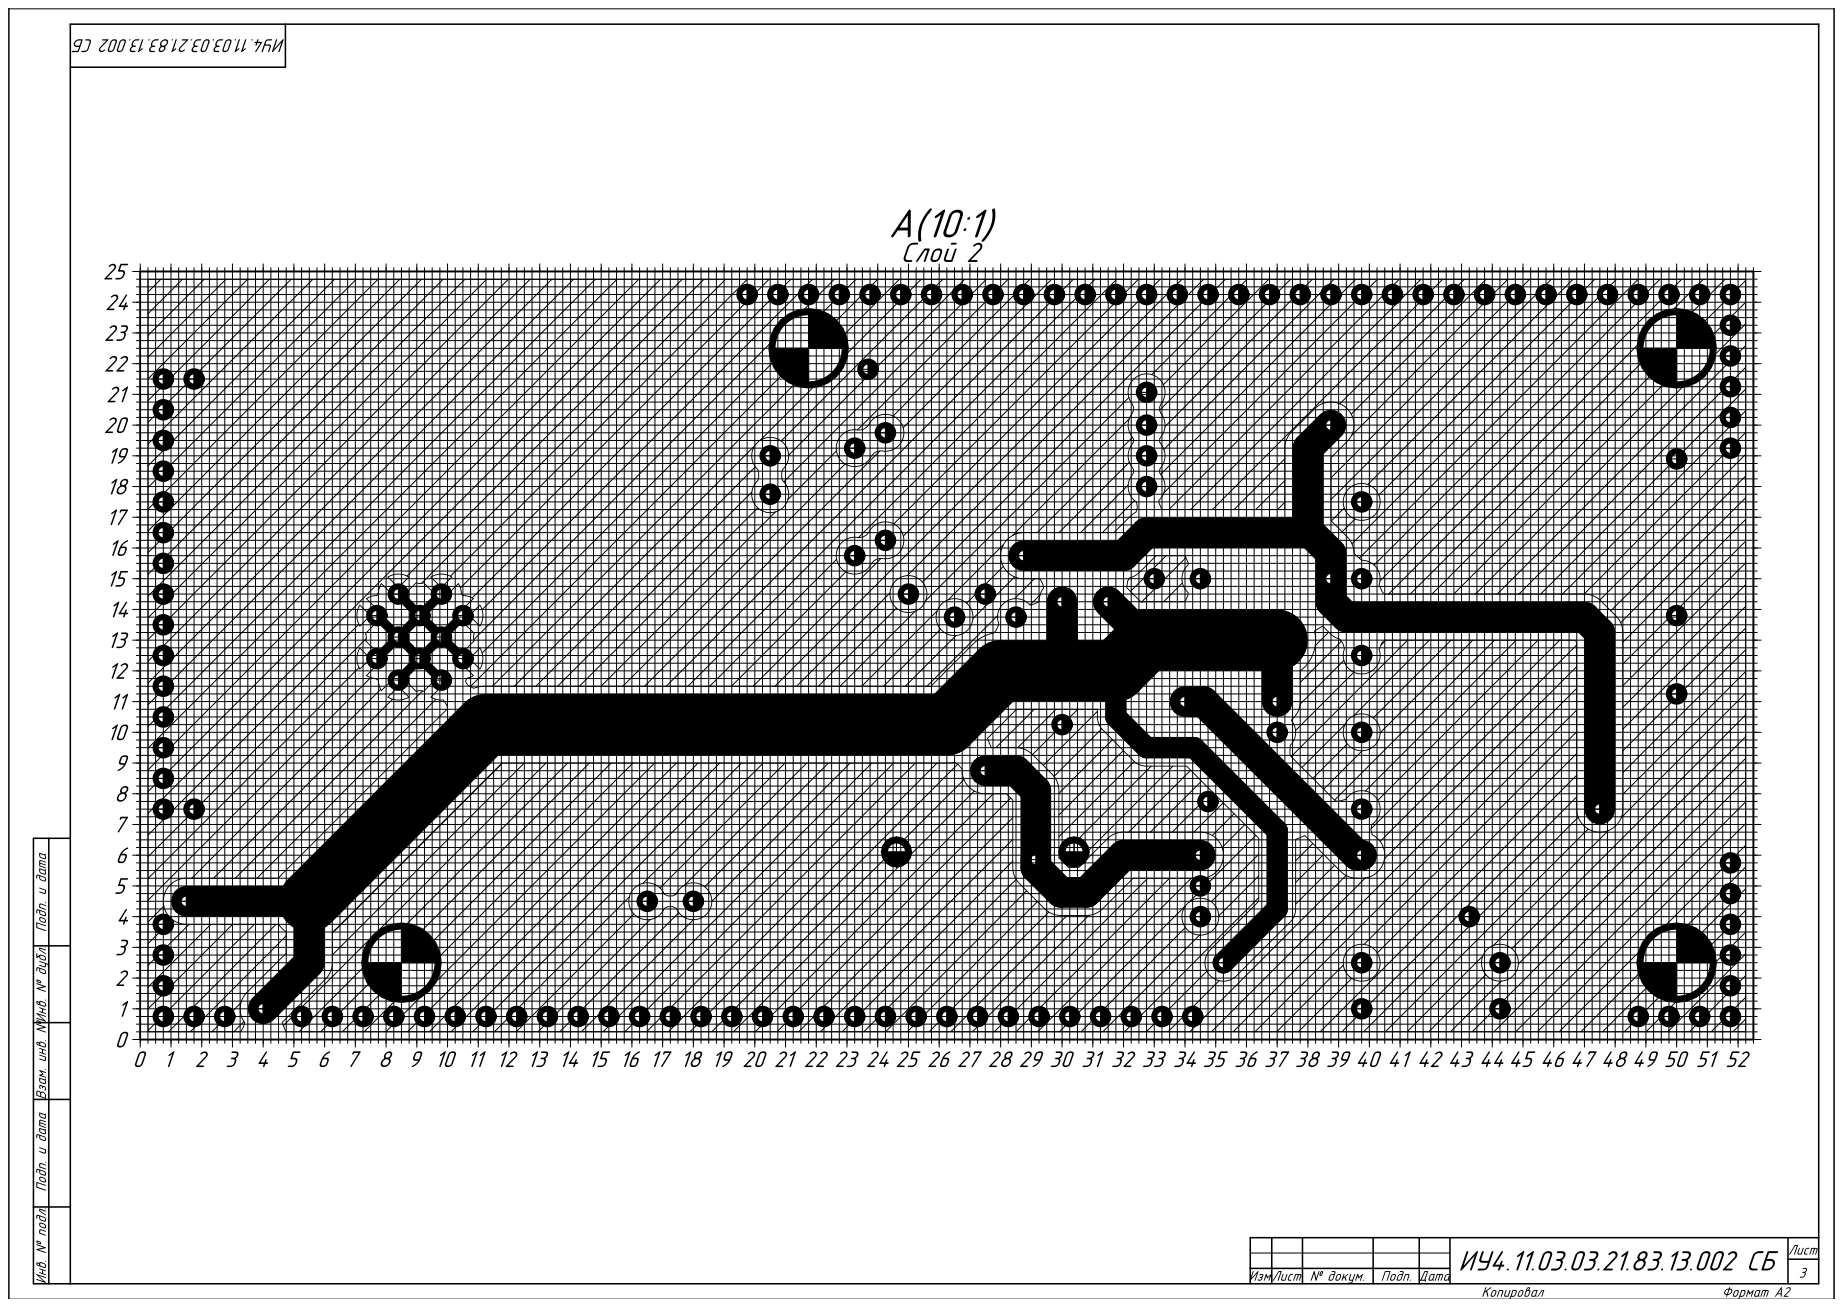
[picture p98: page 3]

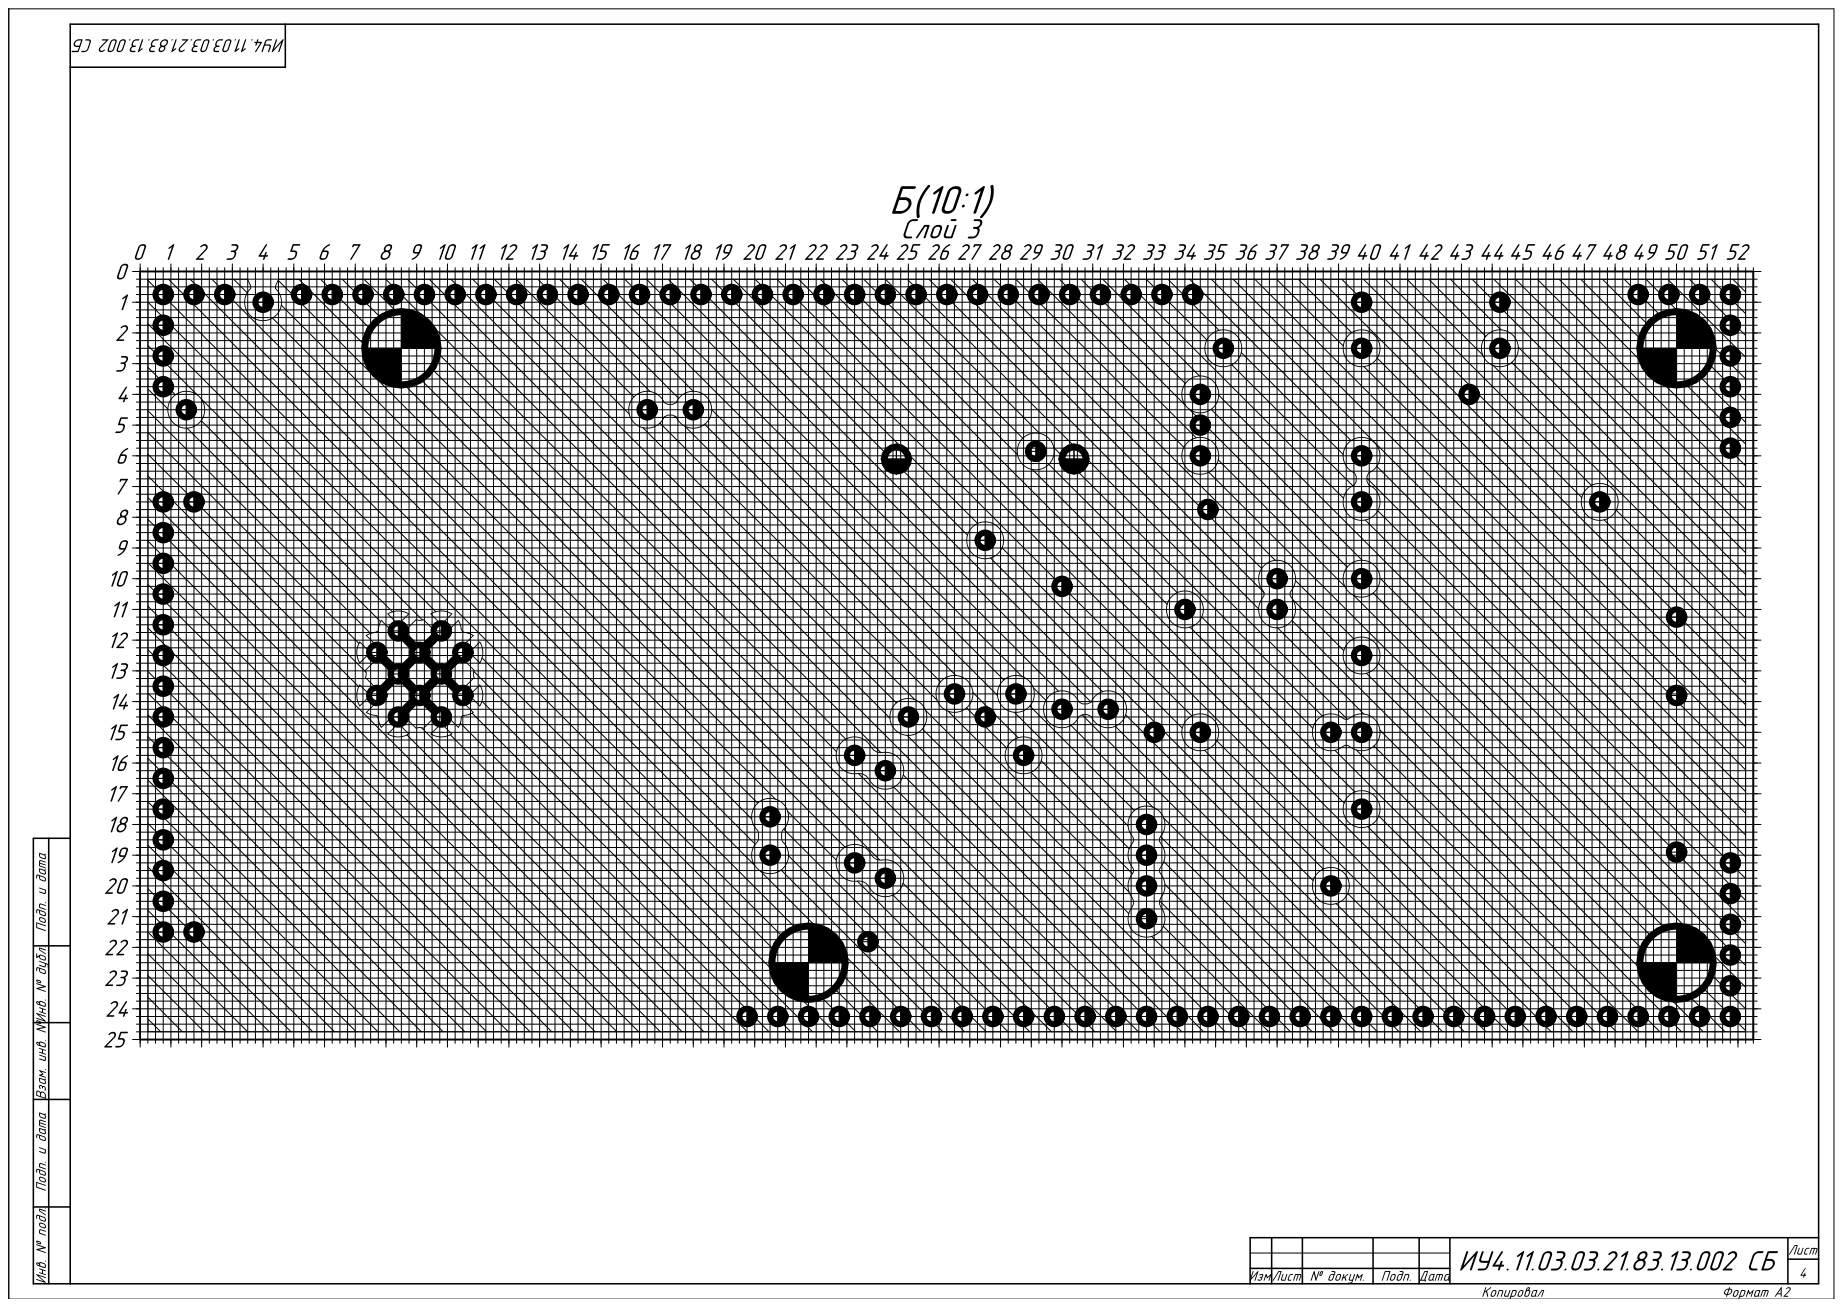
[picture p99: page 4]

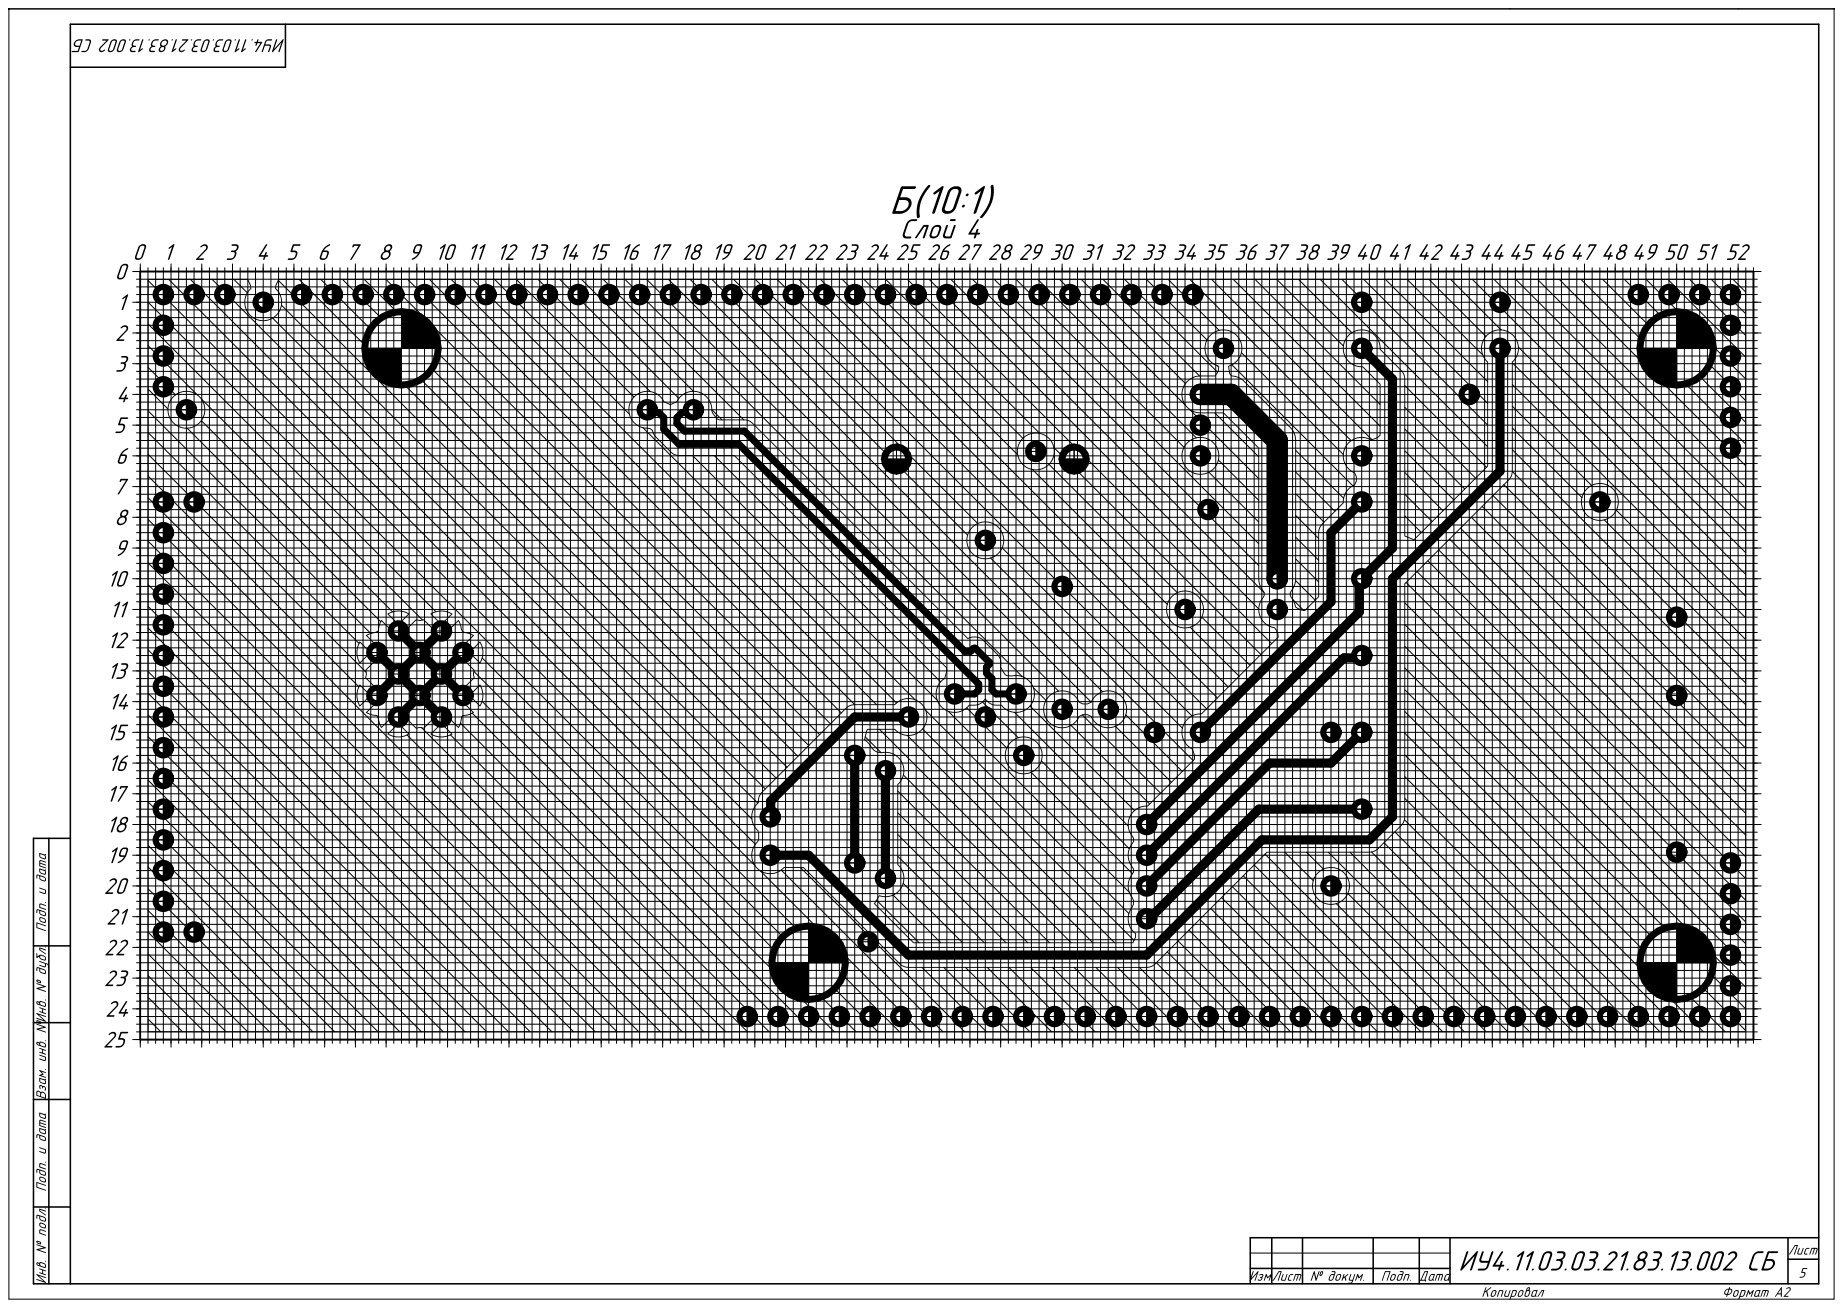
[picture p100: page 5]
