kruglovvs/usbip_debugger/docs/pcba.pdf

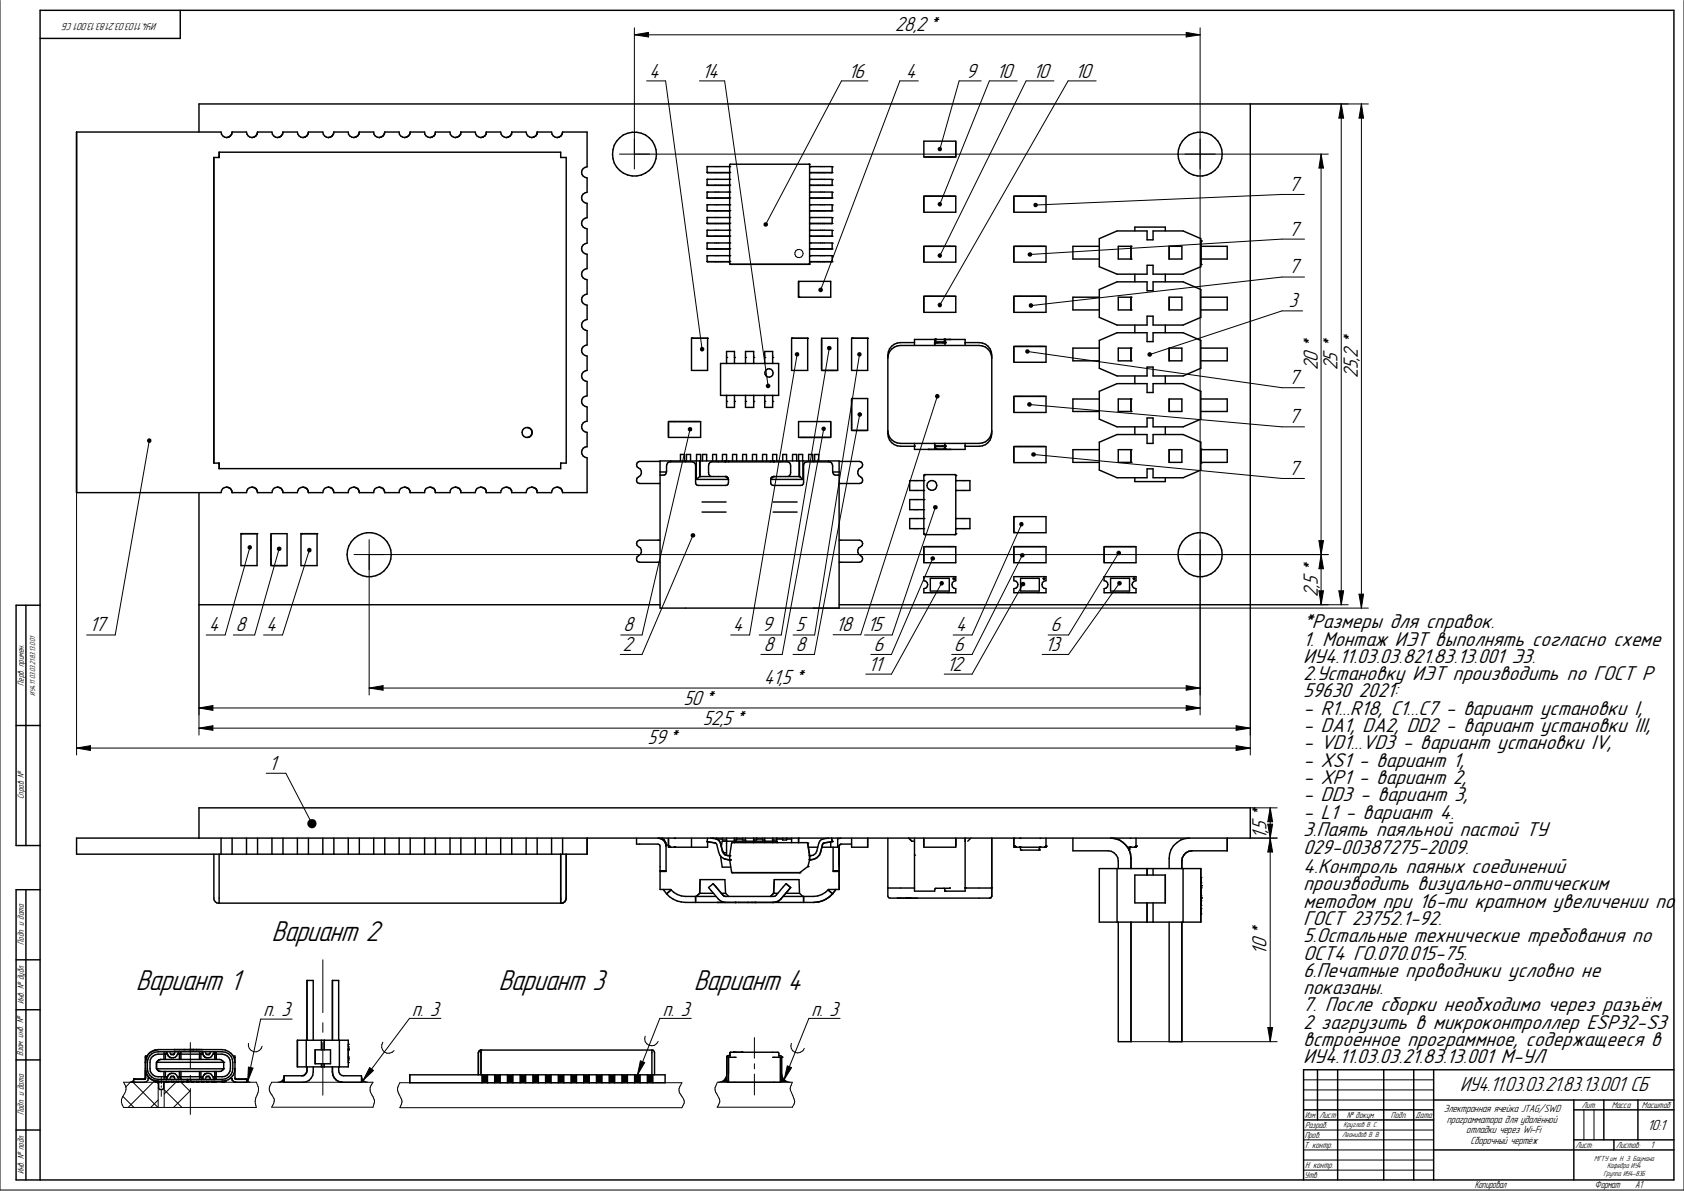
[picture p101: page 1]
Вариант 1; Вариант 2; Вариант 3; Вариант 4

*Размеры для справок.
1. Монтаж ИЭТ выполнять согласно схеме
2.Установку ИЭТ производить по ГОСТ Р
- R1...R18, C1...C7 - вариант установки I,
- DA1, DA2, DD2 - вариант установки III,
- VD1...VD3 - вариант установки IV,
- XS1 - вариант 1,
- XP1 - вариант 2,
- DD3 - вариант 3,
- L1 - вариант 4.
3.Паять паяльной пастой ТУ
4.Контроль паяных соединений
производить визуально-оптическим
методом при 16-ти кратном увеличении по
ГОСТ 23752.1-92.
5.Остальные технические требования по
ОСТ4 ГО.070.015-75.
6.Печатные проводники условно не
показаны.
7. После сборки необходимо через разъём
2 загрузить в микроконтроллер ESP32-S3
встроенное программное, содержащееся в

Инв. № подл. Подп. и дата Взам. инв. № Инв. № дубл. Подп. и дата Справ. № Перв. примен.

Электронная ячейка JTAG/SWD Копировал программатора для удалённой отладки через Wi-Fi Сборочный чертёж | Лит. Формат A1 Изм. Лист | Масса | Масштаб
Пров. | № докум. Леонидов В. В. | Подп. | Дата
Разраб. | Круглов В. С.

Т. контр. | | | | Лист: | Листов: 1

МГТУ им. Н. Э. Баумана Кафедра ИУ4 Группа ИУ4-83Б

Н. контр.
Утв.
