kruglovvs/usbip_debugger/docs/structure.pdf

# Модуль питания

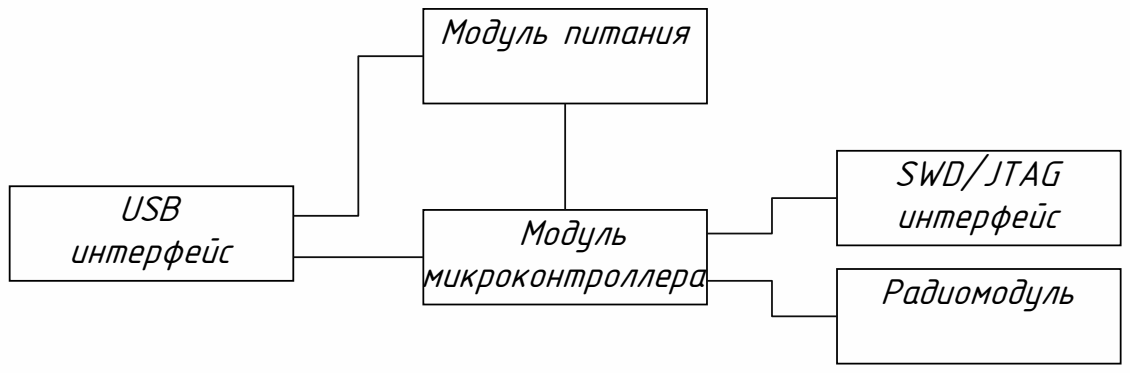
[picture p102: page 1]
Модуль; микроконтроллера; Радиомодуль; USB интерфейс; SWD/JTAG интерфейс

Электронная ячейка JTAG/SWD программатора для удалённой отладки через Wi-Fi Схема электрическая структурная

Круглов В.С.
Леонидов В.В.

МГТУ им. Н. Э. Баумана Кафедра ИУ4 Группа ИУ4-83Б
