kruglovvs/usbip_debugger/(list of files, drawings)

Other design files:
hardware/project/functions.SchDoc
hardware/project/pcb.PcbDoc
hardware/project/Project.PrjPcb
hardware/project/schematic.SchDoc
hardware/project/structure.SchDoc
