kruglovvs/usbip_debugger/(commit log)

2024-09-08 create hardware project part folder and pcb
    [PCB.PcbDoc, Project.PrjPcb, functions.SchDoc, principal.SchDoc, structure.SchDoc]
2024-11-10 ver 1 schematic
    [PCB.PcbDoc, principal.SchDoc]
2024-11-18 add swither power supply
    [PCB.PcbDoc, Project.PrjPcb, principal.SchDoc]
2024-12-24 pcb is done
    [Project.PrjPcb, functions.SchDoc, principal.SchDoc, structure.SchDoc]
2025-03-02 some improvements
    [principal.SchDoc]
2025-03-18 update pcb draft
    [Project.PrjPcb]
2025-03-31 add assembly and pcb dfts
    [Project.PrjPcb, principal.SchDoc]
2025-04-08 improve txb0106 package and pcb
    [Project.PrjPcb, principal.SchDoc]
2025-04-17 add tlv52469 spice modeling
    [Project.PrjPcb, tlv62569.sch]
2025-05-05 add tlv62569 spice model
    [tlv62569.sch]
2025-05-05 set ignorecase=false
    [Project.PrjPcb, functions.SchDoc, principal.SchDoc, structure.SchDoc, tlv62569.sch]
2025-05-17 make principal schematic a2
    [principal.SchDoc]
2025-05-22 recreate case
2025-05-22 add case parts
    [Project.PrjPcb, device.cfg, functions.SchDoc, pcb.cfg, principal.SchDoc, structure.SchDoc]
2025-06-07 ver 0.5 hardware/model
    [tlv62569.sch]
2025-06-07 ver 0.5 hardware/case device
    [pcb.cfg]
2025-06-07 ver 0.5 hardware/project
    [Project.PrjPcb, connections.SchDoc, principal.SchDoc]
2025-06-07 ver 0.5 hardware/case pattern
    [pattern.stp]
2025-06-07 ver 0..5 hardware/case parts
2025-06-07 ver 0.5 hardware/case device.cfg
    [device.cfg]
2025-06-09 add FEM simulation
    [heat.FCStd, tlv62569.sch]
2025-06-11 ver 1.1
    [Project.PrjPcb, device.cfg, functions.SchDoc, pcb.cfg, principal.SchDoc, schematic.SchDoc, structure.SchDoc]
2025-06-15 improve pcb
    [Project.PrjPcb, device.cfg, schematic.SchDoc]
2025-06-17 version 3
    [Project.PrjPcb]
